cc90202/DCC-esp32/docs/hardware/dcc_loco3_found.png

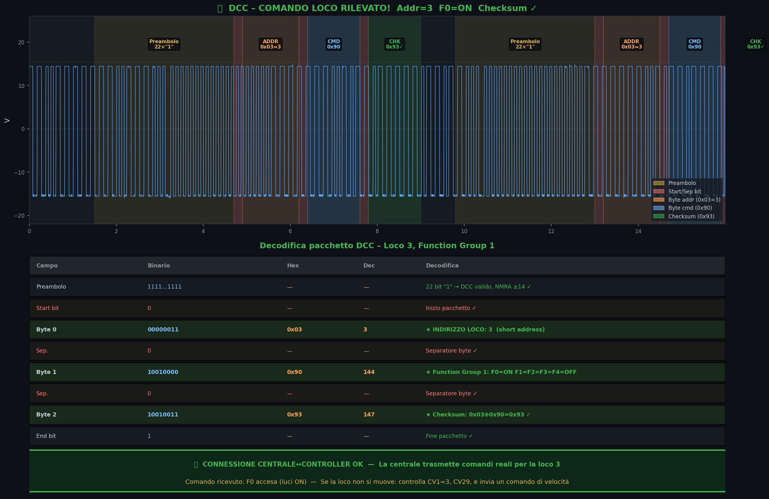
docs/hardware/dcc_loco3_found.png
