cc90202/DCC-esp32/hardware/pcb/fab/board-3d.png

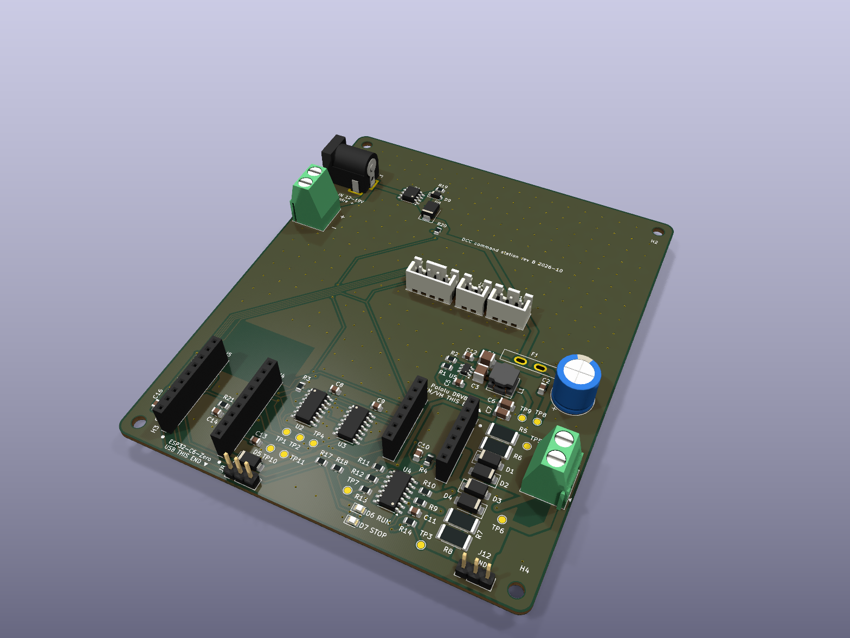
hardware/pcb/fab/board-3d.png
