cc90202/DCC-esp32/docs/specs/wifi-runtime-provisioning.md

# WiFi runtime provisioning

## Goal

Replace build-time WiFi credentials from `.env` with runtime provisioning on
the ESP32-C6.

The command station must:

- use WiFi credentials stored in persistent flash;
- enter setup automatically when no credentials are stored;
- enter setup manually when the blue Resume button on GPIO21 is held for at
  least 10 seconds;
- expose a simple mobile-friendly web page from the ESP32 during setup;
- save the submitted credentials and use them on later boots.

The first implementation should favor predictable embedded behavior over a
fully featured captive portal.

## Current state

WiFi credentials are now loaded from the dedicated `dcc_cfg` flash partition
before station mode starts. The old `.env`/`env!("WIFI_*")` path has been
removed from the runtime and build script.

Provisioning mode now starts a safe SoftAP branch:

- missing credentials select provisioning mode and keep the normal Z21 runtime
  stopped;
- provisioning mode starts WPA2 AP `DCC-Setup-XXXX` on `192.168.4.1`;
- provisioning DHCP assigns `192.168.4.2/24` to the setup client;
- HTTP form handling, credential save, and post-save reboot are implemented;
- OLED feedback shows setup mode, AP SSID, setup URL, and track-disabled state;
- valid stored credentials start station mode;
- runtime GPIO21 provisioning requests first request track stop, then set a
  next-boot flag and reboot into the safe SoftAP branch.

The physical control buttons are already wired and used:

- red Stop button: GPIO22, active-low;
- blue Resume button: GPIO21, active-low;
- both use internal pull-ups and debounce logic in `control_buttons`.

GPIO0/BOOT is not part of this design.

## User flow

### Normal boot

1. Firmware reads stored WiFi credentials from flash.
2. If credentials exist and the blue button override is not active, it starts
   station mode using those credentials.
3. Existing Z21 UDP and runtime services start after WiFi is configured.

If credentials exist but the configured WiFi network is unavailable, the
firmware must keep retrying station mode and must not erase the stored
credentials automatically. The operator can enter setup manually with the
GPIO21 10 second press if the credentials need to be replaced.

### First boot, or missing credentials

1. Firmware finds no valid stored credentials.
2. It enters WiFi setup mode.
3. Track power remains disabled.
4. ESP32 starts an access point named `DCC-Setup-XXXX`.
5. User connects from phone or laptop.
6. User opens `http://192.168.4.1`.
7. The page asks for SSID and password.
8. Firmware validates and saves credentials.
9. Firmware reboots.
10. Next boot starts station mode with the saved credentials.

### Manual setup

The blue Resume button keeps its runtime behavior, with a longer threshold for
provisioning:

```text
GPIO21 blue / Resume
  press < 2s       -> ResumeShortPressed
  press 2s..10s    -> ResumeLongPressed
  press >= 10s     -> WiFi provisioning mode

GPIO22 red / Stop
  press            -> StopPressed
```

The Resume task must not emit `ResumeLongPressed` as soon as 2 seconds elapse.
It should classify the press on release, or on the 10 second timeout, so that a
10 second setup request does not also trigger the 2 second resume action.

Runtime provisioning requests are allowed. When GPIO21 reaches the 10 second
threshold, the firmware should transition to provisioning mode only after
putting the track in a safe disabled state. If this transition is too invasive
for the first implementation, the fallback is to set a persistent
`force_provisioning_on_next_boot` flag and reboot.

## Architecture

Use Clean Architecture principles pragmatically. This is bare-metal firmware,
so the goal is not many abstract layers. The useful boundary is:

- pure policy and validation should not depend on `esp-radio`, HTTP, HTML, or
  flash APIs;
- hardware and protocol details should stay in outer modules;
- the boot composition root wires the concrete pieces together.

## Core types

Introduce a small pure module for WiFi configuration policy, for example:

```text
src/net/wifi_config/
  mod.rs
  credentials.rs
  provisioning_policy.rs
```

Core data:

```rust
pub struct WifiCredentials {
    ssid: heapless::String<32>,
    password: heapless::String<64>,
}

impl WifiCredentials {
    pub fn new(ssid: &str, password: &str) -> Result<Self, CredentialError>;
    pub fn ssid(&self) -> &str;
    pub fn password(&self) -> &str;
}
```

Validation rules:

- SSID must not be empty;
- SSID must be at most 32 bytes;
- password must be empty only if open networks are explicitly supported;
- WPA/WPA2 password must be 8 to 63 bytes;
- password must never be logged.

Initial version should reject open networks unless there is a clear hardware
test need for them.

`password` uses capacity 64 so the type has headroom, but accepted WPA/WPA2
password length is still 8..=63 bytes.

## Provisioning decision

The boot decision should be testable on the host:

```rust
pub enum ProvisioningDecision {
    StationMode,
    ProvisioningMode(ProvisioningReason),
}

pub enum ProvisioningReason {
    MissingCredentials,
    ButtonOverride,
    InvalidStoredCredentials,
}
```

Inputs:

- result of loading stored credentials;
- whether GPIO21 was held for at least 10 seconds;
- whether the stored blob validates.

Rules:

- button override wins;
- missing credentials enter provisioning;
- invalid stored credentials enter provisioning;
- otherwise start station mode.

Connection failures after valid credentials are loaded are not a provisioning
decision. They remain a station-mode reconnect problem until the operator
explicitly requests setup or the stored config is found corrupt.

## Storage port

Define the storage boundary near the policy:

```rust
pub trait WifiCredentialsStore {
    fn load(&mut self) -> Result<Option<WifiCredentials>, StoreError>;
    fn save(&mut self, credentials: &WifiCredentials) -> Result<(), StoreError>;
    fn clear(&mut self) -> Result<(), StoreError>;
}
```

On embedded Rust this can be implemented as a concrete type with equivalent
methods if trait ergonomics or lifetime constraints become awkward. The
important part is the direction of dependency: WiFi policy should not know the
flash driver.

## Persistent format

Use a small versioned record in a dedicated application-owned flash partition.

Selected format:

```text
magic: "DCCWIFI"
version: 1
generation
flags
ssid_len
password_len
ssid bytes
password bytes
checksum
```

Requirements:

- distinguish missing config from corrupt config;
- reject partial/corrupt writes;
- allow overwriting credentials;
- allow clearing credentials later;
- avoid logging secret contents.

### Storage spike decision

Decision for the first runtime provisioning release: use a dedicated versioned
blob in a small application-owned flash partition, not NVS.

Rationale:

- the current stack is `esp-hal`/`esp-rtos`/`esp-radio`, not ESP-IDF;
- `esp-radio` on ESP32-C6 currently needs local NVS symbol stubs in
  `src/net/mod.rs`, so treating NVS as an application persistence dependency
  would couple this feature to a storage path that is not actually initialized;
- the project already has `partitions.csv`, so a dedicated data partition is
  explicit and reviewable;
- blob encode/decode, checksum validation, corruption handling, and flag
  semantics can be host-tested without flash hardware;
- the concrete flash driver remains an outer detail and can be replaced later
  without changing WiFi provisioning policy.

The partition added for this feature, as it appears in `partitions.csv`:

```text
# Name,     Type, SubType, Offset,  Size,    Flags
dcc_cfg,    data, nvs,     0x1E0000, 0x3000,
```

To keep the 2 MiB flash layout valid, the factory app partition was shrunk from
`0x1F0000` to `0x1D0000` so that `dcc_cfg` fits at `0x1E0000`. Application
credentials are deliberately kept out of the pre-existing `nvs` partition, which
stays available for platform and radio use: `dcc_cfg` shares its subtype but is
a separate partition with its own offset, owned by the application.

Flash layout inside `dcc_cfg`:

- three 4 KiB erase sectors, with the first two used by the store;
- one fixed-size credential record per sector: slot A and slot B;
- each record contains a monotonically increasing generation counter;
- load chooses the newest valid record using wrapping generation comparison;
- save erases and writes only the inactive sector, then subsequent loads prefer
  the newer valid slot after checksum validation;
- clear erases both slots;
- missing means both slots are erased (`0xff`);
- corrupt means at least one slot contains non-empty bytes but no slot validates.

The third sector is reserved to keep the implementation on
`esp_bootloader_esp_idf::partitions::FlashRegion`: version `0.4.0` rejects an
erase whose `to` bound is exactly the partition end, while slot B erase ends at
`0x2000`.

Record shape:

```text
magic: "DCCWIFI"
version: 1
generation: u32
flags: u8
ssid_len: u8
password_len: u8
ssid bytes [32]
password bytes [64]
padding to 4-byte boundary
checksum: u32
```

Flags:

- bit 0: `force_provisioning_on_next_boot`;
- all other bits must be zero in version 1.

Checksum:

- use a small deterministic checksum implemented in the host-testable codec;
- checksum covers every record byte except the checksum field itself;
- checksum mismatch maps to corrupt config, never to missing config.

Reset strategy:

- after credentials are saved successfully from the setup flow, call
  `esp_hal::system::software_reset()`;
- the same API is already used by panic/fail-fast paths in `src/bin/main.rs`,
  so no new reset dependency is introduced;
- do not reset until the store reports a successful save.

Power-loss behavior:

- power loss during inactive-sector erase/write leaves the previous valid
  sector active;
- power loss after the inactive slot validates makes the newer generation
  active;
- if both slots are corrupt, boot enters provisioning due to
  `InvalidStoredCredentials`;
- this behavior needs HIL validation before relying on field updates.

Typed error surface:

```rust
pub enum StoreError {
    FlashRead,
    FlashErase,
    FlashWrite,
    Corrupt,
    MissingCredentials,
    BufferTooSmall,
}
```

The codec should distinguish `Missing` from `Corrupt`; the flash adapter should
map driver errors to read/erase/write variants without logging credentials.

## WiFi module changes

`src/net/wifi.rs` no longer uses compile-time credentials:

```rust
env!("WIFI_SSID")
env!("WIFI_PASS")
```

to runtime input:

```rust
pub(super) fn client_mode_config(credentials: &WifiCredentials) -> ModeConfig
```

The network task receives credentials from boot wiring rather than reading them
from environment variables.

## Provisioning mode

Provisioning mode should be exclusive in the first implementation.

When active:

- do not start normal Z21 networking;
- keep track power disabled;
- do not initialize DCC/RMT, RailCom, scheduler, or track-output tasks;
- start WiFi AP mode;
- start HTTP server;
- save credentials;
- reboot after successful save in Task 12.

This is safer and simpler than trying to run setup mode while the DCC runtime
is active. Provisioning is a safe setup branch: while credentials are being
configured, every train on the circuit must remain stopped because no DCC
waveform or track enable path is started.

Operator feedback:

- OLED, when available, should show setup mode, AP SSID,
  `http://192.168.4.1`, and track-disabled state;
- serial logs may show AP SSID and setup URL;
- serial logs must never show passwords, including the submitted station
  password and the fixed provisioning AP password;
- status LEDs may keep the existing WiFi-connecting indication unless a
  dedicated setup pattern is added later.

## Access point

Initial AP:

```text
SSID: DCC-Setup-XXXX
URL:  http://192.168.4.1
```

`XXXX` is derived from a stable chip identifier or MAC suffix.

AP password:

- first version uses WPA2 with fixed password `dcc-setup`;
- do not use an open AP;
- document the password in README; do not print it on the serial log.

### Access point spike decision

Use the SoftAP support already exposed by `esp-radio`; do not introduce a
custom WiFi/AP abstraction or raw radio setup.

Relevant upstream APIs in `esp-radio 0.17.0`:

```rust
esp_radio::wifi::ModeConfig::AccessPoint(AccessPointConfig)
```

`WifiController::set_config` maps `ModeConfig::AccessPoint` to the native
`WIFI_MODE_AP` mode and applies the AP configuration through `apply_ap_config`.
`esp_radio::wifi::Interfaces` already exposes both station and AP network
devices:

```rust
pub struct Interfaces<'d> {
    pub sta: WifiDevice<'d>,
    pub ap: WifiDevice<'d>,
}
```

Production provisioning mode should therefore use `interfaces.ap` with a
separate `embassy-net` stack runner. The station path should keep using
`interfaces.sta`.

Minimal configuration shape:

```rust
let ap_config = ModeConfig::AccessPoint(
    AccessPointConfig::default()
        .with_ssid("DCC-Setup-XXXX".into())
        .with_password("dcc-setup".into())
        .with_auth_method(AuthMethod::Wpa2Personal)
        .with_max_connections(1),
);
wifi_controller.set_config(&ap_config)?;
wifi_controller.start_async().await?;
```

Keep `max_connections` low for setup mode so the AP admits only the expected
single-phone provisioning flow.

AP IP address:

- bind the ESP32 AP interface to `192.168.4.1/24`;
- use `embassy_net::Config::ipv4_static`;
- no gateway is needed for the ESP32 setup page;
- DNS servers can remain empty for the first release.

Expected stack configuration:

```rust
let config = embassy_net::Config::ipv4_static(StaticConfigV4 {
    address: Ipv4Cidr::new(Ipv4Address::new(192, 168, 4, 1), 24),
    gateway: None,
    dns_servers: heapless::Vec::new(),
});
```

DHCP decision:

- phone clients need automatic IP assignment for acceptable UX;
- `embassy-net`'s current `dhcpv4` feature is a DHCP client socket, not a DHCP
  server;
- `esp-radio` AP mode does not provide a DHCP server through `embassy-net`;
- provisioning mode therefore runs a small DHCP server task over
  `embassy_net::udp::UdpSocket`;
- packet parsing and emission use existing `smoltcp::wire` DHCPv4 primitives;
- the direct `smoltcp` dependency is intentionally feature-limited to
  `proto-dhcpv4`, `medium-ethernet`, and `socket-dhcpv4`: `proto-dhcpv4`
  exposes the DHCP wire types, `medium-ethernet` is required by those wire
  types for Ethernet hardware addresses, and `socket-dhcpv4` satisfies
  `smoltcp` 0.12's socket feature guard when `medium-ethernet` is enabled;
- the first release intentionally leases only `192.168.4.2/24` and does not add
  DNS or captive portal behavior.

HTTP dependency decision:

- the current `embassy-net` feature set is `dhcpv4`, `medium-ethernet`, `tcp`,
  and `udp`;
- AP-only provisioning does not need Z21 UDP sockets, station reconnect logic,
  or normal network status events.

Composition and lifetime decision:

- `boot.rs` remains the composition root;
- station mode and provisioning mode are mutually exclusive boot branches;
- the provisioning branch owns `peripherals.WIFI`, starts AP + HTTP, and never
  starts Z21 or DCC runtime tasks;
- radio initialization should be factored so station and provisioning paths do
  not duplicate `esp_radio::init` statics;
- track output must stay disabled before and during AP/HTTP provisioning.

HIL checks required before production HTTP work:

- ESP32-C6 advertises `DCC-Setup-XXXX` with WPA2;
- a phone can associate with the AP;
- ESP32 binds `192.168.4.1/24` on `interfaces.ap`;
- DHCP strategy assigns a phone address without manual static configuration;
- added TCP/HTTP buffers fit RAM with display and control tasks disabled in
  provisioning mode.

## HTTP interface

### HTTP implementation spike decision

Use a minimal hand-written HTTP/1.1 handler on top of
`embassy_net::tcp::TcpSocket`; do not add a web framework or generic HTTP
server crate for the first provisioning release.

Rationale:

- the setup server has exactly two routes: `GET /` and `POST /save`;
- the device serves a local, temporary, physically gated setup AP;
- HTTPS, keep-alive, chunked transfer, compression, and file serving are out of
  scope;
- a small parser can be host-tested without WiFi hardware;
- avoiding another HTTP dependency keeps binary size, feature interactions, and
  no_std compatibility risks low.

Required dependency change for the production HTTP task:

```toml
embassy-net = { version = "0.8.0", features = ["dhcpv4", "medium-ethernet", "tcp", "udp"] }
```

`embassy-net 0.8.0` does not expose a `TcpListener`; each server socket is a
`TcpSocket` put into listening mode with `accept(80)`. The first production
version should run one HTTP socket at a time:

```rust
let mut socket = TcpSocket::new(stack, rx_buffer, tx_buffer);
socket.set_timeout(Some(Duration::from_secs(10)));
socket.accept(80).await?;
handle_one_request(&mut socket, store).await;
socket.close();
socket.flush().await?;
```

This matches the setup use case and avoids concurrency/resource bloat. If a
phone opens parallel connections, extra connections may wait or fail; the user
can retry. That is acceptable for the first setup flow.

Use `abort()` only for hard failure paths where no well-formed response can be
sent, such as oversized headers before request classification, timeout while
reading the request, or socket-level connection reset.

Parser boundary:

- keep HTTP parsing in a pure host-testable module;
- embedded socket code only reads bytes, enforces limits, writes responses, and
  calls the parser;
- no `async-trait`, trait objects, or generic parser abstraction are needed;
- use fixed buffers and borrowed slices where possible.

Request limits:

```text
max complete request bytes: 1024
max header section bytes:   768  (includes request line and CRLF CRLF)
max body bytes:             256
max request line bytes:     128  (included in header section)
max single header line:     128
max header count:            16
```

Accounting:

- request bytes are the exact bytes read before response generation;
- header section bytes include request line, all header lines, and the terminal
  `\r\n\r\n`;
- for `POST /save`, `header section bytes + Content-Length` must be <= 1024;
- body bytes must equal `Content-Length` and be <= 256;
- `GET /` must not require a body; any received body bytes are ignored after
  the response because the connection is closed.

Supported requests:

```text
GET / HTTP/1.0
GET / HTTP/1.1
POST /save HTTP/1.0
POST /save HTTP/1.1
```

Malformed or unsupported requests:

- unsupported method: `405 Method Not Allowed`;
- unsupported path: `404 Not Found`;
- unsupported HTTP version: `505 HTTP Version Not Supported`;
- request line longer than 128 bytes: `414 URI Too Long`;
- header section larger than 768 bytes: `431 Request Header Fields Too Large`;
- single header line longer than 128 bytes: `431 Request Header Fields Too Large`;
- more than 16 headers: `431 Request Header Fields Too Large`;
- missing `Content-Length` on `POST /save`: `411 Length Required`;
- duplicate `Content-Length`: `400 Bad Request`;
- invalid `Content-Length`: `400 Bad Request`;
- `Content-Length` plus header section larger than 1024 bytes:
  `413 Payload Too Large`;
- early EOF before declared body length: close connection without saving and
  without claiming success;
- body larger than 256 bytes: `413 Payload Too Large`;
- unsupported content type on `POST /save`: `415 Unsupported Media Type`;
- malformed form or invalid percent encoding: `400 Bad Request`;
- valid form with invalid WiFi credentials: `200 OK` with validation error
  page, because the browser should stay on the setup form.

Timeout behavior:

- set a 10 second socket timeout for accept/read/write work;
- if no complete request arrives before timeout, close or abort the socket
  without saving credentials;
- if the request is already classified and a response can still be sent, return
  `408 Request Timeout` with `Connection: close`;
- timeout must not block the single HTTP socket indefinitely.

Response behavior:

- always send `Connection: close`;
- include `Content-Length`;
- no chunked transfer;
- no keep-alive;
- no redirects in the first release;
- never log the submitted station password.

Form parsing:

- content type: `application/x-www-form-urlencoded`;
- accepted fields: `ssid`, `password`;
- unknown fields ignored;
- duplicate `ssid` or `password` rejected;
- `+` decodes to space;
- `%XX` percent escapes decode only valid bytes;
- invalid percent escapes are rejected;
- decoded SSID/password must be valid UTF-8;
- decoded credentials are validated through `WifiCredentials::new`.

Buffer decision:

- TCP RX buffer: 1024 bytes;
- TCP TX buffer: 1536 bytes for one full response page;
- if the final HTML exceeds the TX buffer, split writes explicitly rather than
  increasing buffers blindly;
- keep `StackResources` sized for AP + HTTP + DHCP sockets.

Open item for Task 11:

- implement and host-test the parser before wiring it to `TcpSocket`;
- then add the `tcp` feature and compile the embedded server path;
- HIL must prove a phone can load `http://192.168.4.1` and submit the form.

Initial routes:

```text
GET  /      -> setup page
POST /save  -> validate and save credentials
```

Optional later route:

```text
GET /status -> JSON status for a richer UI
```

The HTML should be embedded in firmware. It must not depend on CDN assets or
Internet access because the phone is connected to the ESP32 setup AP.

`POST /save` uses `application/x-www-form-urlencoded`.

Request limits:

- reject unsupported content types;
- reject oversized request bodies before parsing;
- first implementation max body length: 256 bytes;
- accepted fields: `ssid`, `password`;
- ignore unknown fields;
- reject duplicate `ssid` or `password` fields.

UI guidelines:

- mobile-first layout;
- clear title: `Configura WiFi DCC`;
- SSID input;
- password input with show/hide toggle;
- primary action: `Salva e riavvia`;
- visible error messages for invalid SSID/password;
- confirmation page after successful save.

Keep it visually polished but simple. No frontend framework.

## Captive portal

Do not include captive portal in the first implementation.

First release:

- user connects to `DCC-Setup-XXXX`;
- user opens `http://192.168.4.1`.

Future release:

- DNS server replies with `192.168.4.1` for all names;
- common Android/iOS captive portal probes redirect to setup page.

Captive portal is useful but adds DNS behavior and mobile OS edge cases. It is
not required to validate the main provisioning path.

## Boot integration

High-level boot flow:

```text
boot
  init minimal runtime
  if GPIO21 is already pressed, wait up to 10s for provisioning override
  load WiFi credentials
  decide StationMode vs ProvisioningMode

  if ProvisioningMode:
      keep track output disabled
      start AP + HTTP setup
      save credentials
      reboot

  if StationMode:
      start normal WiFi station mode
      start Z21 and runtime tasks
```

The exact placement in `boot.rs` should minimize churn. The boot module can
remain the composition root.

Boot must not add a 10 second delay when GPIO21 is not pressed. It should only
wait for the 10 second override window if GPIO21 is already active-low at the
time the provisioning decision is made.

Task 12 final behavior: after successful credential save, call
`esp_hal::system::software_reset()` to reboot after the success response is
sent and flushed successfully. Do not show reboot success or reset until the
store reports that credentials were written successfully.

## Button integration

`control_buttons` should classify GPIO21 press duration into a richer enum:

```rust
pub enum ResumePress {
    Short,
    Long,
    Provisioning,
}
```

Mapping:

```text
Short        < 2s
Long         2s..10s
Provisioning >= 10s
```

Runtime delivery options:

1. Add a provisioning request sender to `resume_button_task`.
2. Emit a generic control event and let a coordinator dispatch to fault manager
   or provisioning.

Recommended first implementation: add a separate provisioning channel. Do not
put provisioning into `FaultEvent`; it is not a fault-manager responsibility.

If provisioning is requested while normal runtime is active, the receiver of
that channel must first disable track output and pause DCC scheduling before
starting setup mode or rebooting into setup mode.

## Tests

Host tests:

- credential validation accepts valid WPA2 credentials;
- credential validation rejects empty SSID;
- credential validation rejects too long SSID;
- credential validation rejects invalid password lengths;
- provisioning decision chooses setup for missing credentials;
- provisioning decision chooses setup for button override;
- provisioning decision chooses station mode for valid credentials;
- button duration maps `<2s`, `2s..10s`, `>=10s` correctly.

Embedded/manual tests:

- flash without credentials enters AP setup;
- phone connects to `DCC-Setup-XXXX`;
- `http://192.168.4.1` serves the setup page;
- invalid form shows an error and does not save;
- valid form saves credentials and triggers automatic reboot;
- next boot connects to configured WiFi;
- valid stored credentials with WiFi unavailable retry station mode and do not
  erase credentials;
- holding GPIO21 for at least 10 seconds re-enters setup;
- boot without GPIO21 pressed does not wait 10 seconds;
- red Stop/GPIO22 behavior is unchanged;
- blue short and long Resume behavior is unchanged below 10 seconds.

## Hardware acceptance checklist

Software validation can cover parsing, storage, policy, reboot decisions, and
target builds. The following checks require ESP32-C6 hardware, OLED when
installed, and a phone or computer connected to the provisioning AP:

- flash firmware with erased or missing WiFi credentials;
- verify setup mode starts automatically;
- verify DCC, RailCom, Z21 UDP, and track output are not started in setup mode;
- verify AP SSID format `DCC-Setup-XXXX`;
- connect to the AP with password `dcc-setup`;
- verify DHCP assigns the client an address on `192.168.4.0/24`;
- open `http://192.168.4.1`;
- submit invalid SSID/password and verify an error page with no save;
- submit valid credentials and verify the success page;
- verify ESP32 reboots after the success response;
- verify next boot connects to the configured WiFi;
- power-cycle and verify credentials persist;
- make configured WiFi unavailable and verify station reconnect retry without
  erasing credentials;
- hold GPIO21 for at least 10 seconds and verify safe setup mode on next boot;
- verify GPIO21 short press still performs Resume;
- verify GPIO21 press >= 2 seconds and < 10 seconds still performs long Resume
  behavior and does not enter setup;
- verify GPIO22 Stop/E-stop behavior is unchanged;
- verify OLED shows setup mode, AP SSID, `http://192.168.4.1`, and
  track-disabled state when display is installed;
- capture serial logs and verify they show AP SSID and setup URL but never the
  fixed AP password or submitted station password.

Current validation status in this task: `cargo test-host`, `cargo check-esp`,
`cargo build-esp-release`, `cargo fmt --check`, host `cargo clippy`, and
`git diff --check` passed. Hardware-in-the-loop acceptance testing remains required before
treating the feature as physically validated on the command-station board.

## Security and safety

Safety:

- provisioning mode must keep track power disabled;
- setup should not emit DCC packets;
- failed WiFi connection should not energize the track by itself.

Security:

- never log WiFi password;
- do not expose provisioning page in normal station mode;
- do not run AP indefinitely when station mode is working;
- use physical button or missing credentials as the setup gate.

First implementation does not need HTTPS. The setup AP is local, temporary,
and physically gated. This is acceptable for the project scope.

## Implementation phases

### Phase 1: policy and button classification

- Add `WifiCredentials`.
- Add validation.
- Add provisioning decision logic.
- Add GPIO21 duration classification tests.

### Phase 2: runtime credentials input

- Change `wifi::client_mode_config` to accept `WifiCredentials`.
- Remove direct `env!` usage from normal WiFi path.
- Do not retain `.env` as a runtime credential path.

### Phase 3: persistent store

- Implement `dcc_cfg` flash blob storage.
- Add encode/decode tests for stored record format.
- Treat corrupt config as `InvalidStoredCredentials`.
- Keep the previously valid slot active if save is interrupted during inactive
  sector erase/write.
- Prefer the newer generation only after the inactive slot validates.

### Phase 4: provisioning access point and HTTP

- Start AP mode.
- Serve embedded HTML.
- Validate form submission.
- Save credentials.
- Reboot.

### Phase 5: documentation and acceptance testing

- Update README setup instructions.
- Update hardware docs for GPIO21 10 second setup action.
- Run host tests and `cargo check-esp`.
- Perform hardware provisioning test from phone.

## Non-goals for the first version

- captive portal DNS;
- WiFi network scanning;
- admin password management;
- OTA firmware upload;
- editing credentials while normal Z21 runtime is active;
- HTTPS.

These can be added after the basic setup path is stable on hardware.
