cc90202/DCC-esp32/hardware/pcb/fab/board-bottom.png

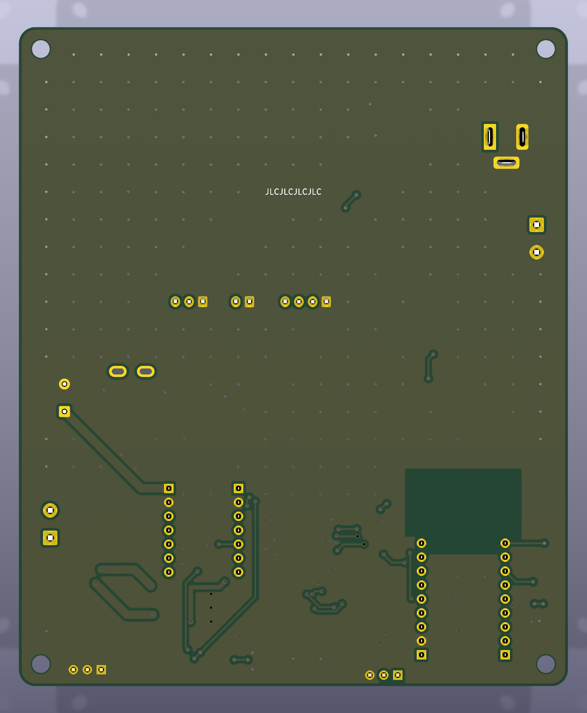
hardware/pcb/fab/board-bottom.png
