cc90202/DCC-esp32/hardware/pcb/fab/board-top.png

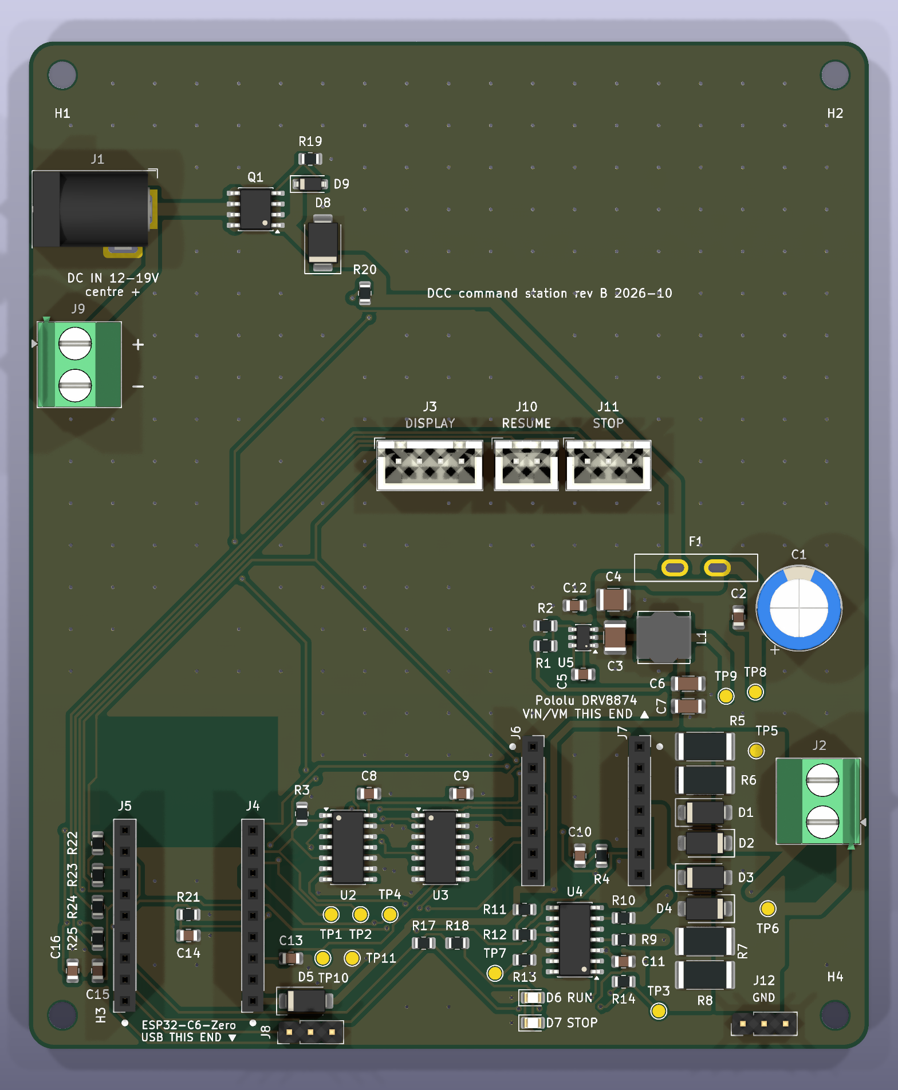
hardware/pcb/fab/board-top.png
