cc90202/DCC-esp32/hardware/pcb/fab/dcc-station-bom.csv

Comment | Designator | Footprint | LCSC Part #
470uF 35V | C1 | CP_Radial_D10.0mm_P5.00mm | C2835692
100nF 50V X7R | C2,C5,C8,C9,C10,C11,C12,C13,C14,C15,C16 | C_0805_2012Metric | C49678
10uF 50V X7R | C3,C4 | C_1210_3225Metric | C138687
22uF 25V | C6,C7 | C_1206_3216Metric | C12891
SS34 | D1,D2,D3,D4 | D_SMA | C8678
SS14 | D5 | D_SMA | C2480
LED green 0805 | D6 | LED_0805_2012Metric | C2297
LED red 0805 | D7 | LED_0805_2012Metric | C84256
SMBJ24A | D8 | D_SMB | C135060
BZT52C12 | D9 | D_SOD-123 | C727004
MF-R400 4A 30V | F1 | Polyfuse_Radial_P5.08mm_W14.5mm | C208488
DC-005-5A-2.5 | J1 | BarrelJack_XKB_DC-005-5A | C381115
TRACK | J2,J9 | TerminalBlock_Phoenix_MKDS-1,5-2_1x02_P5.00mm_Horizontal | C474950
DISPLAY | J3 | JST_XH_B4B-XH-A_1x04_P2.50mm_Vertical | C144395
ESP32-C6-Zero left row | J4,J5 | PinSocket_1x09_P2.54mm_Vertical | C22438159
Pololu DRV8874 #4035 left row | J6,J7 | PinSocket_1x07_P2.54mm_Vertical | C54876729
SERIAL TX RX GND | J8,J12 | PinHeader_1x03_P2.54mm_Vertical | C2937625
RESUME | J10 | JST_XH_B2B-XH-A_1x02_P2.50mm_Vertical | C158012
STOP | J11 | JST_XH_B3B-XH-A_1x03_P2.50mm_Vertical | C144394
10uH 3A | L1 | L_Bourns_SRN6045TA | C2046332
AO4407A | Q1 | SOIC-8_3.9x4.9mm_P1.27mm | C2841482
100k 1% | R1,R20,R3,R19 | R_0805_2012Metric | C96346
13.7k 1% | R2 | R_0805_2012Metric | C17448
10k | R4,R21,R22,R23 | R_0805_2012Metric | C17414
4.7R 1W | R5,R6,R7,R8 | R_2512_6332Metric | C25489
1k | R9,R10,R14,R24,R25 | R_0805_2012Metric | C17513
22k | R11 | R_0805_2012Metric | C17560
4.7k | R12 | R_0805_2012Metric | C17673
100R | R13 | R_0805_2012Metric | C17408
470R | R17,R18 | R_0805_2012Metric | C17710
74HC08 | U2 | SOIC-14_3.9x8.7mm_P1.27mm | C337768
74HC14 | U3 | SOIC-14_3.9x8.7mm_P1.27mm | C6820
LM339 | U4 | SOIC-14_3.9x8.7mm_P1.27mm | C7948
TPS54302 | U5 | TSOT-23-6 | C311983
