cc90202/DCC-esp32/hardware/pcb/fab/dcc-station.step

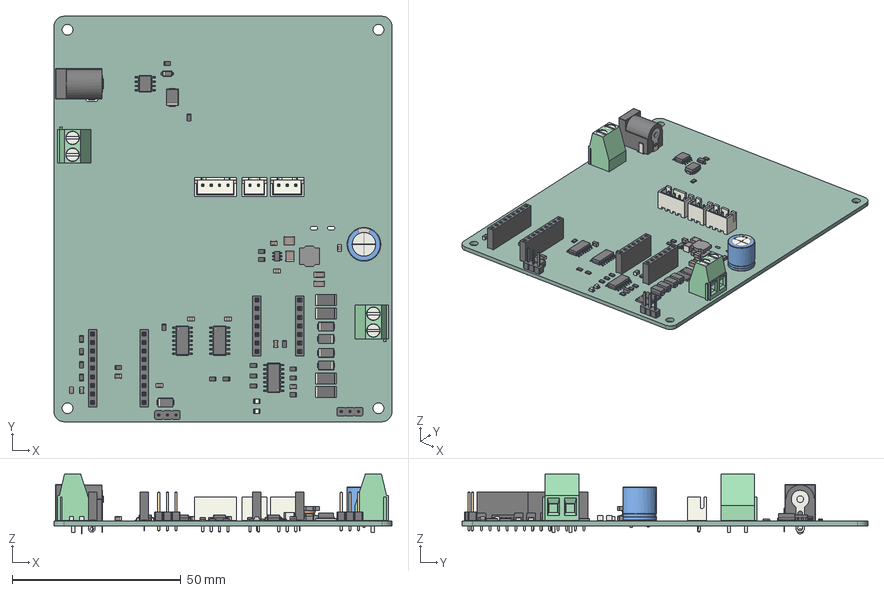
[picture p5: CAD file, 2026-11-02]
hardware/pcb/fab/dcc-station.step
100.0 x 120.0 x 17.7 mm
R_0805_2012Metric x 19
L_Bourns_SRN6045TA
C_0805_2012Metric x 11
D_SMB
SOIC-14_3.9x8.7mm_P1.27mm x 3
PinSocket_1x09_P2.54mm_Vertical x 2
TSOT-23-6
D_SMA x 5
C_1206_3216Metric x 2
LED_0805_2012Metric x 2
C_1210_3225Metric x 2
D_SOD-123
TerminalBlock_Phoenix_MKDS-1,5-2_1x02_P5.00mm_Horizontal x 2
BarrelJack_Horizontal
PinHeader_1x03_P254mm_Vertical x 2
R_2512_6332Metric x 4
JST_B2B_XH_A
SOIC-8_3.9x4.9mm_P1.27mm
CP_Radial_D100mm_P500mm
PinSocket_1x07_P2.54mm_Vertical x 2
JST_B4B_XH_A
JST_B3B_XH_A
dcc-station_PCB
