cc90202/DCC-esp32/docs/hardware/wiring.md

# Breadboard wiring

The single description of the bench circuit: what is connected to what and why
the values are what they are. State on
13 September 2026. It must be updated with every change on the breadboard.

The parts list is in `components-inventory.md`. How the firmware behaves
around the cutout is in `docs/specs/rmt-isr-dcc-railcom-flow.md`.

## What the circuit does

The ESP32-C6 board generates the DCC waveform and feeds it to the DRV8874
H-bridge, which drives the two rails. After every packet addressed to a
locomotive the board opens a RailCom cutout: for about 425 microseconds the
bridge brakes, that is it shorts the two rails together, and the decoder in
the locomotive answers with small current pulses. A resistor in series with
each rail turns those pulses into millivolts, an LM339 comparator turns them
into logic levels and the board's serial port reads them on GPIO5.

## Which standard applies

The RailCom part of this circuit is governed by RCN-217, the RailCommunity
RailCom specification: the detector, the cutout and their timings are defined
there. The NMRA standards cover the DCC waveform itself and, in S-9.3.2, the
decoder's side of the transmission. Links and editions are in
`docs/specs/dcc-railcom-references.md`.

This circuit has not been through a conformance measurement campaign. What is
written here is what was built and what was measured.

The read front end was designed by comparing RCN-217 (edition of 24 November
2025) with three working designs: the example circuit in the standard itself,
the ESP32 detector by Christophe Bobille published by Locoduino, and the
MTB-RC detector by kmzbrnoI. All three use the same comparator we use.

## Power supply

A single star ground, where every return goes: the board, the bridge, the
logic chips and the comparator.

Three supply lines. The 15 V from the bench supply enters only the VIN pin of
the Pololu module. The 5 V is taken from the 5 V output pin of the ESP32-C6
board and feeds the LM339 alone, because that is the operating point the
manufacturer characterises the comparator at. The board's 3.3 V output pin
feeds the 74HC08 and the 74HC14, and is also the pull-up of the comparator
output.

The two logic chips are on 3.3 V and not on 5 V for a reason worth keeping in
mind on the printed board too. Their inputs come from GPIO2 and GPIO4, which
the board drives at 3.3 V, and a chip of the HC family asks for seventy per
cent of its own supply before it reads a level as high: on 5 V that would be
3.5 V, above what the board gives, while on 3.3 V the threshold is about 2.3 V
and there is margin to spare. The measurement agrees: during the cutout the
bridge inputs, which come from the outputs of the 74HC14, sit at about 3.2 V,
that is at the chip's own supply.

The VM pin of the module must not be connected: it is a measurement point
after the protection, not an input.

On the bench both lines come from the output pins of the ESP32-C6 board, and
both are therefore present only while the board is powered. Only on a future
printed board will the comparator's 5 V have to come from a converter fed by
the 15 V.

## The board and its pins

GPIO2 carries the DCC waveform generated by the RMT peripheral. GPIO4 is the
run/cutout signal: high during normal transmission, low during the RailCom
cutout. GPIO18 wakes the bridge and is held low until the firmware is ready.
GPIO5 is the serial input that receives the decoder's answer, with the
internal pull-up enabled. GPIO3 is the short-circuit detector input and comes
from the FAULT pin of the bridge. GPIO19 and GPIO20 are the display data and
clock. GPIO21 and GPIO22 read the resume and stop buttons. GPIO14 and GPIO15
drive the green and red LEDs.

## The bridge and the brake logic

The DRV8874 works in PWM mode: its PMODE pin is at 3.3 V. In this mode the two
inputs IN1 and IN2 drive the two outputs directly, and with both inputs high
the bridge brakes. GPIO18 reaches the sleep pin of the module, the one the
firmware calls SLEEP and holds low until it is ready; the exact wording of the
silkscreen next to that pin on the Pololu carrier has to be read on the board
itself. The two outputs OUT1 and OUT2 go to the two rails, each through its own
sense resistor, and the module's ground goes to the star ground.

The two inputs do not come from the board directly; they pass through two AND
gates of the 74HC08 and two inverters of the 74HC14. The first AND gate
receives the DCC waveform from GPIO2 and the run signal from GPIO4; the second
receives the DCC waveform inverted by one 74HC14 inverter and the same run
signal. The gate outputs, pins 3 and 6 of the 74HC08, enter two 74HC14
inverters, pins 5 and 9, and their outputs, pins 6 and 8, go to the bridge
inputs crosswise: IN1 from pin 8, IN2 from pin 6.

The pin numbers on the input side of the two logic chips are not recorded in
any earlier document and have not been checked component by component on the
breadboard; what follows is what the standard pinouts of the two parts allow,
given the output pins above, and it is the one thing in this section still to
be confirmed by eye. On the 74HC08 the gate whose output is pin 3 has its
inputs on pins 1 and 2, and the gate whose output is pin 6 has its inputs on
pins 4 and 5: GPIO2 and GPIO4 therefore land on pins 1 and 2 in some order, and
the inverted waveform and GPIO4 on pins 4 and 5 in some order. Which of the two
pins of each pair carries which signal makes no difference electrically,
because an AND gate treats its inputs alike. The 74HC14 inverter that produces
the inverted waveform for the second gate is not the one on pins 5 and 6 nor
the one on pins 9 and 8, since those two are already used after the gates: it
is one of the four remaining, whose inputs are pins 1, 3, 11 and 13 and whose
outputs are, in the same order, pins 2, 4, 10 and 12.

Both logic chips take their 3.3 V on pin 14 and their ground on pin 7, and it
is across those two pins that the 100 nF of each sits. The inputs of the unused
gates and inverters are not described in the earlier documents either, and what
they are tied to, if anything, has to be checked on the breadboard.

As a result, outside the cutout the bridge reproduces the DCC waveform as
before, and inside the cutout, with GPIO4 low, both inputs rise and the bridge
brakes. Measured on 1 September: during the cutout both inputs sit at about
3.2 V and the rails are at zero.

The firmware does not command a duration but two instants, both counted from
the reference edge, that is from the polarity inversion that closes the packet:
the brake comes in at 28 microseconds and is released at 454. The brake itself
therefore lasts about 425 microseconds. The capture of 2 September measures a
33 microsecond stub before the brake and 424 microseconds of rails at zero,
which puts the end at 457 from the edge against the 454 commanded: the bridge
is some three microseconds late in letting go.

On the run signal, between GPIO4 and the 74HC08, a resistor to ground holds the
pin low while the board is not yet driving it; the design value is 100 kΩ. A
low run signal means brake, so what this resistor gives at power-up is a
defined state, not an idle one: the bridge is harmless in that moment because
GPIO18 is low and the bridge is asleep, not because of this resistor.

## The short-circuit detector

The FAULT pin of the bridge goes to GPIO3, so the firmware's detector watches
the bridge. On that pin there is a capacitor to ground, confirmed by eye on the
bench; the value is 100 nF as far as the notes go, and whether a resistor is
fitted with it, and where, has not been settled. The pin is open drain and
active low, so it can only pull down; the line is held up by the pull-up inside
the ESP32-C6, which the firmware enables on GPIO3, and that pull-up is weak,
around 45 kΩ, so the capacitor slows the line down appreciably when FAULT lets
go. This matters for the open bug below.

## The sense resistors

Between the bridge output and each of the two rails sits a sense resistor: two
4.7 Ω resistors in parallel, about 2.35 Ω. Across each one, two 1N5819 diodes
in anti-parallel let the traction current through and leave the much smaller
decoder current alone. Both rails are equipped the same way.

The decoder current produces tens of millivolts across each resistor; its
direction depends on how the locomotive sits on the track, which is why the
comparator watches both rails. Outside the cutout the two nodes swing with the
DCC waveform and the diodes keep them within half a volt.

One resistor per rail is our own variation. The standard and the other designs
use a single resistor and build a negative supply to see the opposite
direction too; having only positive voltages, we put one resistor per rail.
During braking one node goes above zero and the other below, and watching the
one above is enough.

The diodes are in all three reference designs. At the 130 millivolts measured
with only the decoder signal present they conduct a few microamperes and steal
nothing; above half a volt, that is when traction current flows, they divert it
through themselves.

## The comparator

The LM339 is powered at 5 V on pin 3, with ground on pin 12 and a 100 nF
capacitor between the two.

The threshold is a voltage of about 18.5 mV obtained from a divider between the
5 V and ground, 22 kΩ plus 4.7 kΩ on top and 100 Ω at the bottom, brought to
pins 5 and 7. It corresponds to 8 mA through the sense resistor. The standard
requires the detector to read a current above ten milliamperes as a zero and
below six as a one: the threshold must fall in that band, and eight is the
value recommended by OpenDCC.

The rail-side node of the first sense resistor reaches pin 4 and that of the
second reaches pin 6, each through a 1 kΩ resistor that protects the chip while
those nodes swing by tens of volts outside the cutout.

Pins 4 and 6 are the inverting inputs of the first two comparators of the
LM339, and pins 5 and 7, which carry the threshold, are the non-inverting ones.
The output therefore goes low when the signal rises above the threshold, that
is when current is flowing, and is high when there is none. This is the reason
for what the measurements show on GPIO5: the line rests high during the cutout
and the decoder's pulses appear as short trips to ground.

The two outputs, pins 1 and 2, are tied together: they are open collector and
can only pull low. From the common node a 1 kΩ resistor goes up to the 3.3 V,
not to the 5 V, so GPIO5 never sees more than 3.3 V. The same node goes to
GPIO5.

The manufacturer characterises the LM339 at 5 V, so that is the operating point
with guaranteed numbers. Because its outputs can only pull down, the pull-up to
3.3 V means the board pin cannot see more than 3.3 V under any condition, not
even a fault.

## Display, buttons and LEDs

The earlier breadboard documents that described this part have been lost, so
what follows is what the firmware requires. It is right about the electrical
arrangement, because the firmware would not work otherwise, but it has not
been checked against the breadboard component by component.

**Display.** The SSD1306 module sits on the board's I2C bus at 400 kHz, data on
GPIO19 and clock on GPIO20, plus its supply and ground. The bus pull-ups are
the ones on the module; none are fitted on the breadboard, and the inventory
lists none.

**Buttons.** Both inputs are configured with the pull-up inside the ESP32-C6
and the firmware reads a press as a low level. Each button therefore has one
side on its pin, GPIO21 for resume and GPIO22 for stop, and the other side on
the star ground. No external resistor is needed and none is in the inventory.

**LEDs.** Both are plain outputs driven high to light, green on GPIO14 and red
on GPIO15, so each LED has its anode towards the pin and its cathode towards
ground. The inventory lists no series resistors for them; whether one is fitted
on each, and of what value, is the one thing in this section that has to be
checked by eye on the breadboard.

## The capacitors

Five, all 100 nF. Four are one per chip on its supply: 74HC08 and 74HC14
between their pins 14 and 7, on the 3.3 V, LM339 between its pins 3 and 12, on
the 5 V, and one on the ESP32-C6 board. The fifth is on GPIO3, towards ground,
on the fault line. There is none on the bridge module.

## Assembling the read front end

This is the procedure followed on 7 September 2026 for the comparator and the
sense resistors. All the assembly is done with the circuit off, supply
disconnected and USB cable unplugged.

1. Before anything else, with the multimeter and the circuit off, check that
   there is no continuity between the 5 V line and ground, and likewise
   between 3.3 V and ground.

2. Plug the socket across the centre channel of the breadboard, in a free area,
   with the reference notch facing up. Insert the LM339 in the socket following
   that notch.

3. A wire from pin 3 to the 5 V line. A wire from pin 12 to the star ground,
   the same used for everything else.

4. A 100 nF capacitor directly between pin 3 and pin 12, as short as possible.

5. Pick a free row of the breadboard: it will be the threshold node. From the
   5 V line, put a 22 kΩ and a 4.7 kΩ resistor in series, with the second one
   landing on that row.

6. From the same row, a 100 Ω resistor to ground.

7. From the threshold row, one wire to pin 5 and another to pin 7.

8. On each rail, break the direct link between the bridge output and the track
   and put two 4.7 Ω resistors in parallel in its place, so that the current
   from the bridge output to the rail has to pass through them.

9. Across each pair, two 1N5819 diodes facing opposite ways: the first with its
   band towards the track side, the second with its band towards the bridge
   side.

10. From the track-side node of the first pair, not the bridge side, a 1 kΩ
   resistor to pin 4. From the track-side node of the second pair, a 1 kΩ
   resistor to pin 6.

11. Join pin 1 and pin 2, which are adjacent, with a short wire. The two
    outputs work together: the one that sees current pulls the common wire
    down, the other watches.

12. From that common node, a 1 kΩ resistor to the **3.3 V** line, 3.3 and not
    five. This resistor sets the high level, and it is the reason the board pin
    will never see more than 3.3 V.

13. From the same common node, the wire to GPIO5 on the board.

14. Repeat the check of step 1 and add two more: that pin 3 is not in contact
    with ground, and that the common output node is not either.

**Two things not to get wrong.** The signal inputs are pins 4 and 6, the
threshold goes to pins 5 and 7; swapped, the circuit works backwards and the
board's serial port understands nothing. The resistor of step 12 goes to 3.3 V;
taking it to five by mistake sends five volts into a pin rated for 3.3.

## Open bug: the fault with two locomotives

Since 10 September 2026, with two locomotives on the track, the short-circuit
detector trips 17 milliseconds after the track is powered. With a single
locomotive the bench starts cleanly. The log puts the power at 5.537 s and the
short at 5.663 s, and the detector needs fifteen low samples out of twenty at
one millisecond, so the line stays low for the whole window. The bench supply
reads 0.08 A, which is no short at all.

The lead to follow is the inrush that charges the capacitors of the
two decoders: the bridge sees an overcurrent, retries every few milliseconds,
and FAULT pulses long enough for the detector to call it a short. The
measurement agreed for this, still to be done, is one probe on GPIO3 and one on
a rail at 5 ms per division, triggered on the falling edge of GPIO3, powering up
with both locomotives. A burst of pulses on FAULT while the waveform on the
rail breaks up means inrush; a single fall that stays down means something else.

Worth keeping in mind while reading the capture: GPIO3 carries a capacitor to
ground and is held up only by the weak pull-up inside the chip, so the line
rises slowly. A FAULT that pulses briefly can therefore look, on the pin, like
a line that stays down, and that alone could be enough to make the detector
call a short where there is none.

## What is no longer there

The H-bridge of the first build, the two TLV3501 comparators, the external
terminator with the IRLZ44N MOSFETs and their burden resistors, and the 74HC14
inverter on the board's serial input, which served an earlier front end and is
now replaced by the pull-up to 3.3 V.
