cc90202/DCC-esp32/hardware/pcb/dcc-station.kicad_pcb

## KiCad design hardware/pcb/dcc-station.kicad_pcb (2026-10-24)

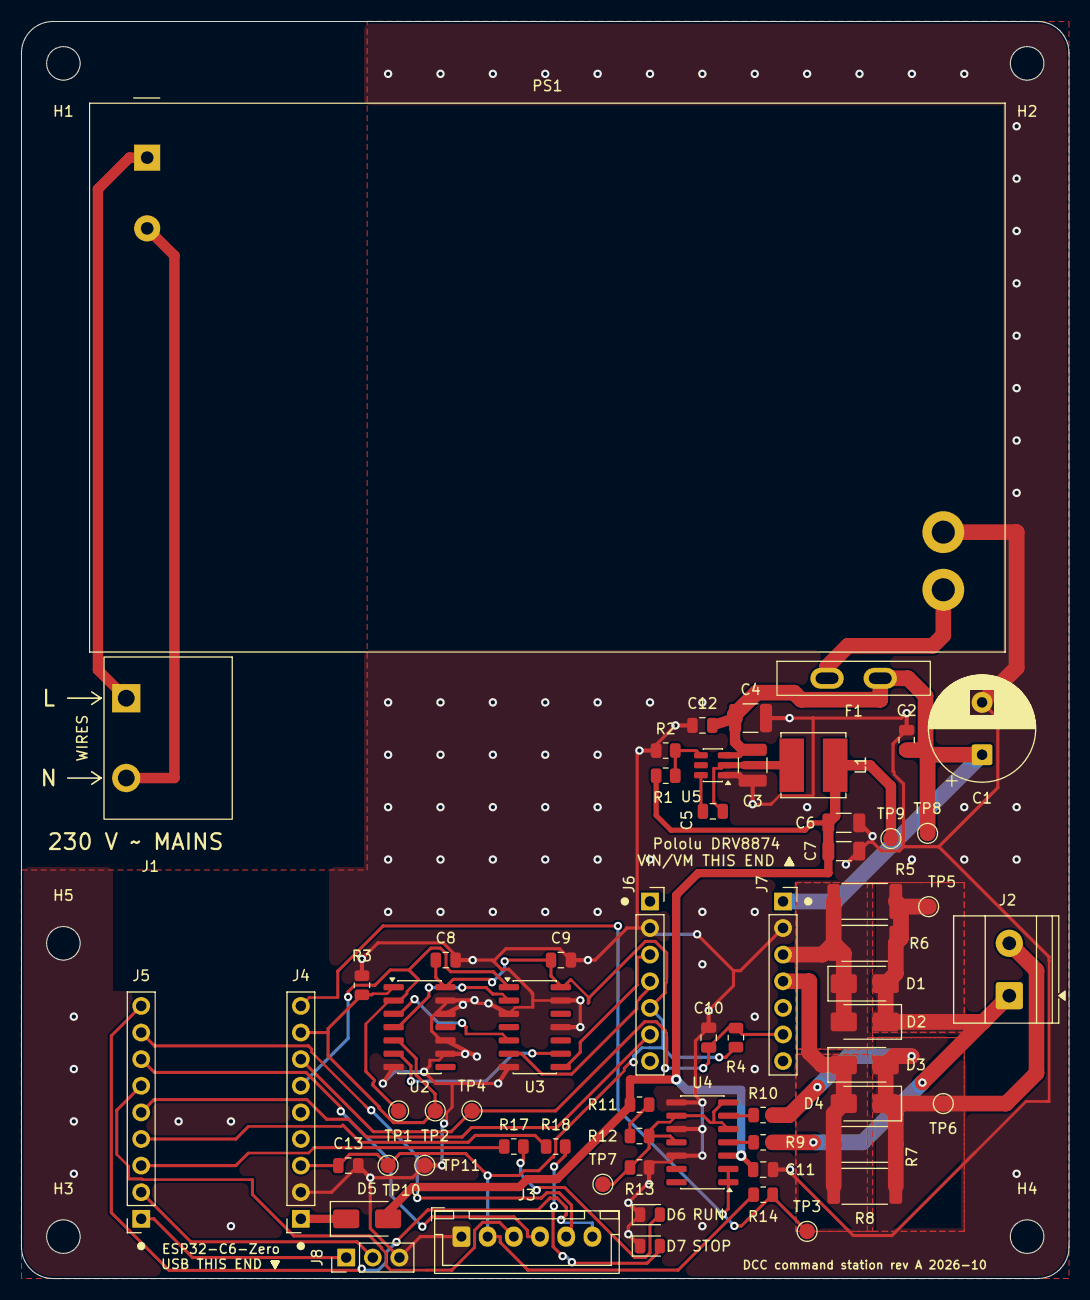
[picture p6: board dcc-station.kicad_pcb from above]

Board: 2 copper layers, 100.0 x 120.0 mm, 67 parts (0 on the bottom side), 39 nets.

Parts:
C1: 470uF 25V; CP_Radial_D10.0mm_P5.00mm
C2, C5, C8, C9, C10, C11, C12, C13: 100nF 50V X7R; C_0805_2012Metric
C3, C4: 10uF 50V X7R; C_1210_3225Metric
C6, C7: 22uF 25V; C_1206_3216Metric
D1, D2, D3, D4: SS34; D_SMA
D5: SS14; D_SMA
D6: LED green 0805; LED_0805_2012Metric
D7: LED red 0805; LED_0805_2012Metric
F1: MF-R400 4A 30V; Polyfuse_Radial_P5.08mm_W14.5mm
H1, H2, H3, H4, H5: M3; MountingHole_3.2mm_M3
J1: MAINS L N 7.62mm; TerminalBlock_7.62mm_1x02
J2: TRACK; TerminalBlock_Phoenix_MKDS-1,5-2_1x02_P5.00mm_Horizontal
J3: PANEL; JST_XH_B6B-XH-A_1x06_P2.50mm_Vertical
J4: ESP32-C6-Zero left row; PinSocket_1x09_P2.54mm_Vertical
J5: ESP32-C6-Zero right row; PinSocket_1x09_P2.54mm_Vertical
J6: Pololu DRV8874 #4035 left row; PinSocket_1x07_P2.54mm_Vertical
J7: Pololu DRV8874 #4035 right row; PinSocket_1x07_P2.54mm_Vertical
J8: SERIAL TX RX GND; PinHeader_1x03_P2.54mm_Vertical
L1: 10uH 3A; L_Bourns_SRN6045TA
PS1: IRM-45-15; Converter_ACDC_MeanWell_IRM-60-xx_THT
R1: 100k 1%; R_0805_2012Metric
R2: 13.7k 1%; R_0805_2012Metric
R3: 100k; R_0805_2012Metric
R4: 10k; R_0805_2012Metric
R5, R6, R7, R8: 4.7R 1W; R_2512_6332Metric
R9, R10, R14: 1k; R_0805_2012Metric
R11: 22k; R_0805_2012Metric
R12: 4.7k; R_0805_2012Metric
R13: 100R; R_0805_2012Metric
R17, R18: 470R; R_0805_2012Metric
TP1: TP1; TestPoint_Pad_D1.5mm
TP2: TP2; TestPoint_Pad_D1.5mm
TP3: TP3; TestPoint_Pad_D1.5mm
TP4: TP4; TestPoint_Pad_D1.5mm
TP5: TP5; TestPoint_Pad_D1.5mm
TP6: TP6; TestPoint_Pad_D1.5mm
TP7: TP7; TestPoint_Pad_D1.5mm
TP8: TP8; TestPoint_Pad_D1.5mm
TP9: TP9; TestPoint_Pad_D1.5mm
TP10: TP10; TestPoint_Pad_D1.5mm
TP11: TP11; TestPoint_Pad_D1.5mm
U2: 74HC08; SOIC-14_3.9x8.7mm_P1.27mm
U3: 74HC14; SOIC-14_3.9x8.7mm_P1.27mm
U4: LM339; SOIC-14_3.9x8.7mm_P1.27mm
U5: TPS54302; TSOT-23-6

Connections:
+3V3: C8.1, C9.1, C13.1, J3.2, J4.3, J6.5, R4.1, R14.1, TP10.1, U2.14, U3.14
+5V: C6.1, C7.1, C11.1, D5.2, L1.2, R1.1, R11.1, TP9.1, U4.3
+5V_ESP: D5.1, J4.1
+15V: C1.1, C2.1, C3.1, C4.1, C12.1, F1.2, J7.1, TP8.1, U5.3
+15V_RAW: F1.1, PS1.3
AC_L: J1.1, PS1.1
AC_N: J1.2, PS1.2
AND1: U2.3, U3.5
AND2: U2.6, U3.9
BOOT: C5.1, U5.6
CMP_INA: R9.2, U4.4
CMP_INB: R10.2, U4.6
DCC_INV: U2.4, U3.2
FB: R1.2, R2.1, U5.4
GND: C1.2, C2.2, C3.2, C4.2, C6.2, C7.2, C8.2, C9.2, C10.2, C11.2, C12.2, C13.2, D6.1, D7.1, J3.1, J4.2, J6.2, J7.2, J8.3, PS1.4, R2.2, R3.2, R13.2, TP11.1, U2.7, U2.9, U2.10, U2.12, U2.13, U3.3, U3.7, U3.11, U3.13, U4.8, U4.10, U4.12, U5.1
GPIO2: J4.6, TP1.1, U2.2, U3.1
GPIO3: C10.1, J4.7, J7.6, R4.2, TP4.1
GPIO4: J4.8, R3.1, TP2.1, U2.1, U2.5
GPIO14: J5.3, R17.1
GPIO15: J5.4, R18.1
GPIO18: J5.5, J6.6
GPIO19: J3.3, J5.6
GPIO20: J3.4, J5.7
GPIO21: J3.5, J5.8
GPIO22: J3.6, J5.9
IN1: J6.3, U3.8
IN2: J6.4, U3.6
LED_GREEN: D6.2, R17.2
LED_RED: D7.2, R18.2
OUT1: D1.1, D2.2, J7.3, R5.1, R6.1
OUT2: D3.1, D4.2, J7.4, R7.1, R8.1
RAILCOM_RX: J4.9, R14.2, TP3.1, U4.1, U4.2
SENSE_A: D1.2, D2.1, J2.1, R5.2, R6.2, R9.1, TP5.1
SENSE_B: D3.2, D4.1, J2.2, R7.2, R8.2, R10.1, TP6.1
SW: C5.2, L1.1, U5.2
UART0_RX: J5.2, J8.2
UART0_TX: J5.1, J8.1
VTH: R12.2, R13.1, TP7.1, U4.5, U4.7, U4.9, U4.11
VTH_MID: R11.2, R12.1
