cc90202/DCC-esp32/src/railcom/runtime_dispatch.rs

//! Runtime routing for parsed RailCom UART windows.
//!
//! The boot layer wires UART hardware and channels; this module owns the
//! application-level routing of decoded RailCom windows to loco tracking,
//! logon handling, and POM response attribution.

use defmt::{info, warn};

use crate::cutout::LogonCommand;
use crate::dcc::PomRailcomResult;
#[cfg(feature = "dcc-a")]
use crate::dcc::SchedulerCommand;
use crate::dcc::cv::channels::PomRailcomResultSender;
use crate::dcc::scheduler::channels::SchedulerCommandSender;
#[cfg(feature = "dcc-a")]
use crate::dcc::{DecoderUid, LogonAnswer};
use crate::macros::bench_diag;
use crate::railcom::loco_tracker::{FragmentWindow, RailcomLocoSighting};
use crate::railcom::parser::{LogonPairing, ParseError, RailcomLogonResponse};
use crate::railcom::pipeline::{
    RailcomRxResult, record_pom_result_dropped, record_pom_result_forwarded, rx_overflow_total,
};
use crate::railcom::pom_dispatch::evaluate_pom_window;
use crate::railcom::uart_reader::{RailcomRxOutput, RailcomRxOutputReceiver};
use crate::railcom::{PacketSequence, RailcomChannel, RailcomItem};
use crate::track_output::RailcomPacketMetadata;

#[derive(Default)]
struct LogonDispatchState {
    logon_pairing: LogonPairing,
    /// [`rx_overflow_total`] when the last window was dispatched.
    overflows_seen: u32,
    /// Windows still to dispatch that may predate a lost one.
    suspect_windows: usize,
}

/// Windows that can be on their way to dispatch when the capture side counts
/// a loss: the full queue, plus the one the capture task is sending.
const WINDOWS_IN_FLIGHT: usize = crate::railcom::uart_reader::RX_WINDOW_DEPTH + 1;

impl LogonDispatchState {
    /// A window lost on the way breaks the run of consecutive windows that
    /// pairs address fragments (RCN-217 §4).
    ///
    /// The loss is counted when it happens, while windows captured before it
    /// may still wait in the queue. None of those may hand a high fragment to
    /// one captured after the loss, so the held fragment is dropped before
    /// each of them.
    fn forget_fragment_across_lost_windows(&mut self) {
        let overflows = rx_overflow_total();
        if overflows != self.overflows_seen {
            self.overflows_seen = overflows;
            self.suspect_windows = WINDOWS_IN_FLIGHT;
        }
        if self.suspect_windows > 0 {
            self.suspect_windows -= 1;
            crate::railcom::loco_tracker::forget_pending_fragment();
        }
    }
}

/// Tells the scheduler, which owns the decoder table, what came back after a
/// logon command.
///
/// An answer that cannot be queued is not retried here: the table gives up
/// waiting on its own and sends the command again.
#[cfg(feature = "dcc-a")]
fn report_logon_answer(answer: LogonAnswer, scheduler_sender: SchedulerCommandSender) {
    if scheduler_sender
        .try_send(SchedulerCommand::LogonAnswer(answer))
        .is_err()
    {
        warn!("railcom logon answer: scheduler channel full");
    }
}

#[cfg(feature = "dcc-a")]
fn dispatch_logon_response(
    packet_sequence: PacketSequence,
    response: RailcomLogonResponse,
    scheduler_sender: SchedulerCommandSender,
) {
    let answer = match response {
        RailcomLogonResponse::DecoderId(logon_id) => LogonAnswer::Announced(DecoderUid {
            manufacturer_id: logon_id.manufacturer_id,
            decoder_id: logon_id.decoder_id,
        }),
        RailcomLogonResponse::Select(logon_select) => {
            // The address the decoder asks for is on the track either way:
            // its own, or another locomotive's when the two collide.
            let sighting = crate::railcom::loco_tracker::record_identified_address(
                packet_sequence,
                logon_select.address,
            );
            log_first_sighting("railcom logon address", sighting);
            LogonAnswer::WantsAddress(logon_select.address)
        }
        RailcomLogonResponse::DecoderState(_) => LogonAnswer::Confirmed,
    };
    report_logon_answer(answer, scheduler_sender);
}

/// Without the `dcc-a` feature no logon answer is read, so none reaches
/// this point.
#[cfg(not(feature = "dcc-a"))]
fn dispatch_logon_response(
    _packet_sequence: PacketSequence,
    _response: RailcomLogonResponse,
    _scheduler_sender: SchedulerCommandSender,
) {
}

/// Reports a logon cutout that closed without a readable answer: a select
/// or assign is sent again, and an unreadable answer to a logon enable is
/// two decoders talking together.
///
/// Silence after a logon enable is the normal case and is not reported.
#[cfg(feature = "dcc-a")]
fn report_unreadable_logon_answer(
    command: LogonCommand,
    channel: RailcomChannel,
    answer: Option<&Result<RailcomLogonResponse, ParseError>>,
    scheduler_sender: SchedulerCommandSender,
) {
    if channel != RailcomChannel::Channel2 {
        return;
    }
    let report = match (command, answer) {
        (LogonCommand::Select | LogonCommand::Assign, None | Some(Err(_))) => {
            LogonAnswer::Unanswered(command)
        }
        (LogonCommand::Enable, Some(Err(error))) if error.is_logon_collision() => {
            LogonAnswer::Collided
        }
        _ => return,
    };
    report_logon_answer(report, scheduler_sender);
}

/// Bench diagnostic: what came back after a logon command and was not its
/// answer. Compiled out unless `bench-diag` is enabled: a decoder without
/// DCC-A may talk in these cutouts at every logon enable.
#[cfg_attr(
    not(feature = "bench-diag"),
    expect(
        unused_variables,
        reason = "the diagnostic macro removes its arguments when bench diagnostics are disabled"
    )
)]
fn log_rejected_logon_answer(result: &RailcomRxResult, command: LogonCommand, error: ParseError) {
    bench_diag! {
        info!(
            "railcom logon answer rejected: command={:?} error={:?} raw={=[u8]:#04x} packet={}",
            command,
            error,
            result.window.raw_slice(),
            result.window.packet_sequence,
        );
    }
}

fn log_first_sighting(prefix: &str, sighting: RailcomLocoSighting) {
    // Repeats are hot-path telemetry covered by aggregate counters; only the
    // first sighting is a state transition worth logging.
    if sighting.seen_count == 1 {
        info!(
            "{}: addr={} kind={:?} packet={}",
            prefix,
            sighting.address.value(),
            sighting.address.kind(),
            sighting.packet_sequence,
        );
    }
}

fn record_loco_sighting(
    result: &RailcomRxResult,
    packet_metadata: Option<RailcomPacketMetadata>,
    complete_items: &[RailcomItem],
) {
    let window = match (result.window.channel, packet_metadata) {
        (RailcomChannel::Channel2, _) => FragmentWindow::Channel2,
        (RailcomChannel::Channel1, None) => FragmentWindow::UnknownChannel1,
        (RailcomChannel::Channel1, Some(metadata)) if metadata.target_address.is_some() => {
            FragmentWindow::LocoChannel1
        }
        (RailcomChannel::Channel1, Some(_)) => FragmentWindow::OtherChannel1,
    };
    let direct_sighting = crate::railcom::loco_tracker::record_loco_identification(
        result.window.packet_sequence,
        window,
        complete_items,
    );
    let target_sighting = direct_sighting.or_else(|| {
        packet_metadata
            .and_then(|metadata| metadata.target_address)
            .and_then(|target| {
                crate::railcom::loco_tracker::record_target_from_matching_address_fragment(
                    result.window.packet_sequence,
                    target,
                    complete_items,
                )
            })
    });

    if let Some(sighting) = target_sighting {
        log_first_sighting("railcom loco identified", sighting);
    }
}

fn forward_pom_result(
    result: &RailcomRxResult,
    packet_metadata: Option<RailcomPacketMetadata>,
    complete_items: &[RailcomItem],
    pom_result_sender: PomRailcomResultSender,
) {
    let pom_result = evaluate_pom_window(
        result.window.packet_sequence,
        result.window.channel,
        packet_metadata,
        complete_items,
    );
    log_pom_window(result, packet_metadata, complete_items, pom_result.as_ref());
    let Some(pom_result) = pom_result else {
        return;
    };

    if pom_result_sender.try_send(pom_result).is_ok() {
        record_pom_result_forwarded();
    } else {
        record_pom_result_dropped();
    }
}

/// Bench diagnostic: every channel-2 window of a POM cutout, with what the
/// parser made of it and what reached the POM actor. The periodic raw dump
/// samples one window in a hundred, which never shows the windows of a
/// read that times out.
///
/// Compiled out unless `bench-diag` is enabled. This one is unthrottled and
/// fires during the very reads whose cutout timing we measure, and a defmt
/// line holds a critical section for its whole duration.
#[cfg_attr(
    not(feature = "bench-diag"),
    expect(
        unused_variables,
        reason = "the diagnostic macro removes its arguments when bench diagnostics are disabled"
    )
)]
fn log_pom_window(
    result: &RailcomRxResult,
    packet_metadata: Option<RailcomPacketMetadata>,
    complete_items: &[RailcomItem],
    pom_result: Option<&PomRailcomResult>,
) {
    bench_diag! {
        use crate::cutout::CutoutMode;

        let Some(metadata) = packet_metadata else {
            return;
        };
        if result.window.channel != RailcomChannel::Channel2
            || !matches!(metadata.cutout, CutoutMode::PomRead | CutoutMode::PomWrite)
        {
            return;
        }
        let (value, ack, nack) = match pom_result {
            Some(PomRailcomResult::Window {
                value, ack, nack, ..
            }) => (*value, *ack, *nack),
            _ => (None, false, false),
        };
        // A busy reply yields no verdict, so without this it would read exactly
        // like a window that answered nothing at all.
        let busy = complete_items.contains(&RailcomItem::Busy);
        info!(
            "railcom pom ch2 seq={} req={:?} raw={=[u8]:#04x} outcome={:?} items={} value={:?} ack={} nack={} busy={}",
            result.window.packet_sequence.value(),
            metadata.pom_request_id,
            result.window.raw_slice(),
            result.outcome,
            complete_items.len(),
            value,
            ack,
            nack,
            busy
        );
    }
}

/// Logon command whose answer this window may hold.
///
/// Always none without the `dcc-a` feature (see `Cargo.toml`): no logon
/// answer is read, so no Select goes out.
fn logon_command(packet_metadata: Option<RailcomPacketMetadata>) -> LogonCommand {
    match packet_metadata {
        Some(metadata) if cfg!(feature = "dcc-a") => metadata.logon,
        _ => LogonCommand::None,
    }
}

fn dispatch_processed_window(
    state: &mut LogonDispatchState,
    result: &RailcomRxResult,
    pom_result_sender: PomRailcomResultSender,
    scheduler_sender: SchedulerCommandSender,
) {
    let complete_items = result.complete_items();
    let packet_metadata =
        crate::track_output::railcom_packet_metadata(result.window.packet_sequence);

    state.forget_fragment_across_lost_windows();
    let command = logon_command(packet_metadata);
    let logon_answer = state.logon_pairing.observe(
        command,
        result.window.packet_sequence,
        result.window.channel,
        result.window.raw_slice(),
    );
    #[cfg(feature = "dcc-a")]
    report_unreadable_logon_answer(
        command,
        result.window.channel,
        logon_answer.as_ref(),
        scheduler_sender,
    );
    // A window that completes a logon answer carries a decoder identity, not
    // address datagrams, even when its symbols also parse as an address pair.
    match logon_answer {
        Some(Ok(response)) => {
            dispatch_logon_response(result.window.packet_sequence, response, scheduler_sender);
        }
        Some(Err(error)) => {
            log_rejected_logon_answer(result, command, error);
            record_loco_sighting(result, packet_metadata, complete_items);
        }
        None => record_loco_sighting(result, packet_metadata, complete_items),
    }

    forward_pom_result(result, packet_metadata, complete_items, pom_result_sender);
}

#[embassy_executor::task]
pub async fn railcom_uart_runtime_dispatch_task(
    receiver: RailcomRxOutputReceiver,
    pom_result_sender: PomRailcomResultSender,
    scheduler_sender: SchedulerCommandSender,
) -> ! {
    let mut state = LogonDispatchState::default();

    loop {
        match receiver.receive().await {
            RailcomRxOutput::WindowProcessed(result) => {
                dispatch_processed_window(&mut state, &result, pom_result_sender, scheduler_sender);
            }
            RailcomRxOutput::WindowError(err) => {
                warn!("railcom rx window assembly: {:?}", err);
            }
        }
    }
}
