cc90202/DCC-esp32/src/dcc/engine.rs

//! DCC engine feeder for the ISR-driven RMT backend.

use crate::dcc::channels::{DccFrameReceiver, PowerFenceAckSender};
use crate::dcc::timing::{IDLE_RMT_SIZE, RMT_CLOCK_HZ};
use crate::dcc::{DccPacket, encode_dcc_packet};
use crate::macros::bench_diag;
use crate::rmt_dcc as rmt_driver;
use crate::station_status::{FaultCause, FaultEvent};
use crate::system_status::channels::FaultEventSender;
use dcc_protocol::encoder::{EncodeError, PulseCode as DccPulseCode, encode_dcc_data_portion};
use dcc_protocol::timing::MAX_DATA_PULSES;

use embassy_time::{Duration, Instant, Timer, with_timeout};
use esp_hal::gpio::Level;
use esp_hal::rmt::PulseCode;
use heapless::Vec;

const _: () = assert!(
    RMT_CLOCK_HZ == 1_000_000,
    "RMT_CLOCK_HZ must be 1MHz for direct microsecond-to-tick conversion"
);

const ISR_WATCHDOG_TIMEOUT: Duration = Duration::from_millis(50);
const ISR_RESET_GRACE_PERIOD: Duration = Duration::from_millis(100);

/// Pre-encoded idle waveform used to bootstrap continuous RMT loop mode.
pub(crate) type IdleRmtBuffer = Vec<PulseCode, IDLE_RMT_SIZE>;

/// Errors while preparing the pre-encoded idle waveform.
#[derive(Debug, Clone, Copy, PartialEq, Eq)]
#[cfg_attr(target_arch = "riscv32", derive(defmt::Format))]
pub(crate) enum IdleWaveformBuildError {
    PacketEncoding,
    BufferOverflow,
}

impl core::fmt::Display for IdleWaveformBuildError {
    fn fmt(&self, formatter: &mut core::fmt::Formatter<'_>) -> core::fmt::Result {
        match self {
            Self::PacketEncoding => formatter.write_str("idle DCC packet encoding failed"),
            Self::BufferOverflow => formatter.write_str("idle RMT waveform buffer overflow"),
        }
    }
}

impl core::error::Error for IdleWaveformBuildError {}

/// Errors while converting one DCC packet into the RMT data buffer.
#[derive(Debug, Clone, Copy, PartialEq, Eq)]
#[cfg_attr(target_arch = "riscv32", derive(defmt::Format))]
enum EngineEncodeError {
    Dcc(EncodeError),
    RmtBufferOverflow,
}

struct EncodedRmtPacket {
    data: Vec<PulseCode, MAX_DATA_PULSES>,
    dcc_duration_us: u32,
}

/// Build the pre-encoded idle waveform used to bootstrap the continuous loop.
pub(crate) fn build_idle_rmt_buffer() -> Result<IdleRmtBuffer, IdleWaveformBuildError> {
    let idle_packet = DccPacket::Idle;
    let idle_pulses =
        encode_dcc_packet(&idle_packet).map_err(|_| IdleWaveformBuildError::PacketEncoding)?;
    let mut buf: IdleRmtBuffer = Vec::new();
    for pulse in &idle_pulses {
        let rmt_pulse = convert_pulse_to_rmt(pulse);
        buf.push(rmt_pulse)
            .map_err(|_| IdleWaveformBuildError::BufferOverflow)?;
    }
    buf.push(PulseCode::end_marker())
        .map_err(|_| IdleWaveformBuildError::BufferOverflow)?;
    Ok(buf)
}

/// Pure async feeder paced by the ISR ACK.
pub(crate) async fn dcc_engine_task(
    receiver: DccFrameReceiver,
    fault_sender: FaultEventSender,
    fence_ack_sender: PowerFenceAckSender,
) -> ! {
    defmt::info!("DCC engine feeder started");

    let mut last_heartbeat = rmt_driver::isr_heartbeat();
    let mut last_progress = Instant::now();
    let mut last_ota_stall_log = None;

    loop {
        while !rmt_driver::is_consumed() {
            let heartbeat = rmt_driver::isr_heartbeat();
            if heartbeat != last_heartbeat {
                last_heartbeat = heartbeat;
                last_progress = Instant::now();
                crate::liveness::beat(crate::liveness::Task::Dcc);
            }

            // Sleep until the ISR consumes the slot, but keep the original
            // heartbeat-based watchdog deadline instead of waiting forever.
            let elapsed = Instant::now().duration_since(last_progress);
            let remaining = ISR_WATCHDOG_TIMEOUT
                .checked_sub(elapsed)
                .unwrap_or(Duration::MIN);
            if with_timeout(remaining, rmt_driver::wait_for_packet_consumed())
                .await
                .is_ok()
            {
                continue;
            }

            // A timeout is fatal only when both the packet remains pending and
            // the ISR heartbeat failed to advance during the watchdog window.
            let heartbeat = rmt_driver::isr_heartbeat();
            if heartbeat != last_heartbeat {
                last_heartbeat = heartbeat;
                last_progress = Instant::now();
                crate::liveness::beat(crate::liveness::Task::Dcc);
            } else if !rmt_driver::is_consumed() {
                if crate::track_output::inhibited() && !crate::track_output::is_track_enabled() {
                    let now = Instant::now();
                    if last_ota_stall_log
                        .is_none_or(|last| now.duration_since(last) >= Duration::from_secs(5))
                    {
                        defmt::warn!("RMT watchdog: stall while the track is inhibited; waiting");
                        last_ota_stall_log = Some(now);
                    }
                    // The expired watchdog deadline must not become a busy
                    // loop during flash work. Do not claim DCC progress here.
                    Timer::after(ISR_WATCHDOG_TIMEOUT).await;
                    continue;
                }
                // Cut bridge power before logging, channel delivery or reset
                // grace time. A full fault queue must not keep the track live.
                if !crate::track_output::emergency_disable() {
                    defmt::error!("RMT watchdog: track output hardware unavailable");
                }
                defmt::error!(
                    "RMT ISR heartbeat stalled: heartbeat={}, idle_timeout_ms={}",
                    heartbeat,
                    ISR_WATCHDOG_TIMEOUT.as_millis()
                );
                if fault_sender
                    .try_send(FaultEvent::FaultLatched(FaultCause::Internal))
                    .is_err()
                {
                    defmt::error!("RMT watchdog: fault queue full; track disabled, resetting");
                }
                Timer::after(ISR_RESET_GRACE_PERIOD).await;
                crate::restart::restart();
            }
        }

        let frame = receiver.receive().await;
        bench_diag! {
            frame_queue_stats::record(frame, receiver.len());
        }
        if let Some(generation) = frame.fence_generation() {
            // The feeder only receives after the RMT slot is consumed, and the
            // fence was appended after every preceding scheduler frame.
            fence_ack_sender.send(generation).await;
            crate::liveness::beat(crate::liveness::Task::Dcc);
            continue;
        }
        let next_rmt = match encode_packet_to_rmt_data(&frame.packet()) {
            Ok(buf) => buf,
            Err(error) => {
                defmt::warn!("packet encoding failed, skipping: {:?}", error);
                continue;
            }
        };

        let cutout = frame.effective_cutout();
        if cutout != frame.cutout() {
            defmt::warn!("POM frame missing request id; transmitting without RailCom cutout");
        }
        rmt_driver::submit_packet(
            next_rmt.data.as_slice(),
            next_rmt.dcc_duration_us,
            cutout,
            frame.railcom_target_address(),
            frame.pom_request_id(),
            frame.packet().logon_command(),
        );
        crate::liveness::beat(crate::liveness::Task::Dcc);
    }
}

/// Bench diagnostic: how long frames wait between the scheduler picking them
/// and the engine taking them, and how close the queue comes to running dry.
///
/// A new command waits as long as any frame picked at the same moment, so the
/// longest wait is the delay a speed change or an emergency stop can see
/// before reaching the RMT driver. The lowest fill level after a take shows
/// how much of the queue depth the scheduler actually needs as a reserve.
#[cfg(feature = "bench-diag")]
pub(crate) mod frame_queue_stats {
    use core::sync::atomic::{AtomicU32, Ordering};

    use embassy_time::Instant;

    use crate::dcc::DccFrame;

    static WAIT_MAX_US: AtomicU32 = AtomicU32::new(0);
    static WAIT_TOTAL_US: AtomicU32 = AtomicU32::new(0);
    static FRAMES: AtomicU32 = AtomicU32::new(0);
    /// `u32::MAX` until a frame is taken in the current period.
    static LOWEST_FILL: AtomicU32 = AtomicU32::new(u32::MAX);
    static DRAINED: AtomicU32 = AtomicU32::new(0);

    /// Queue figures since the previous [`take`].
    #[derive(Debug, Clone, Copy, defmt::Format)]
    pub(crate) struct FrameQueueStats {
        pub wait_max_us: u32,
        pub wait_avg_us: u32,
        pub frames: u32,
        /// Frames still queued behind the one just taken, at the lowest.
        pub lowest_fill: Option<u32>,
        /// Takes that left the queue empty.
        pub drained: u32,
    }

    /// Frames the scheduler did not stamp (the boot sequence, power fences)
    /// are left out, so the boot burst does not read as a drained queue.
    pub(super) fn record(frame: DccFrame, queued_behind: usize) {
        let Some(picked_at) = frame.picked_at() else {
            return;
        };
        let wait_us =
            u32::try_from(Instant::now().duration_since(picked_at).as_micros()).unwrap_or(u32::MAX);
        let queued_behind = u32::try_from(queued_behind).unwrap_or(u32::MAX);
        WAIT_MAX_US.fetch_max(wait_us, Ordering::Relaxed);
        WAIT_TOTAL_US.fetch_add(wait_us, Ordering::Relaxed);
        FRAMES.fetch_add(1, Ordering::Relaxed);
        LOWEST_FILL.fetch_min(queued_behind, Ordering::Relaxed);
        if queued_behind == 0 {
            DRAINED.fetch_add(1, Ordering::Relaxed);
        }
    }

    /// Returns the figures of the period that ends now and starts a new one.
    #[must_use]
    pub(crate) fn take() -> FrameQueueStats {
        let frames = FRAMES.swap(0, Ordering::Relaxed);
        let wait_total_us = WAIT_TOTAL_US.swap(0, Ordering::Relaxed);
        FrameQueueStats {
            wait_max_us: WAIT_MAX_US.swap(0, Ordering::Relaxed),
            wait_avg_us: wait_total_us.checked_div(frames).unwrap_or(0),
            frames,
            lowest_fill: Some(LOWEST_FILL.swap(u32::MAX, Ordering::Relaxed))
                .filter(|&fill| fill != u32::MAX),
            drained: DRAINED.swap(0, Ordering::Relaxed),
        }
    }
}

fn encode_packet_to_rmt_data(packet: &DccPacket) -> Result<EncodedRmtPacket, EngineEncodeError> {
    let encoded = encode_dcc_data_portion(packet).map_err(EngineEncodeError::Dcc)?;
    let data =
        convert_to_rmt(&encoded.pulses).map_err(|()| EngineEncodeError::RmtBufferOverflow)?;
    Ok(EncodedRmtPacket {
        data,
        dcc_duration_us: encoded.dcc_duration_us,
    })
}

fn convert_pulse_to_rmt(pulse: &DccPulseCode) -> PulseCode {
    let level1 = if pulse.level1 {
        Level::High
    } else {
        Level::Low
    };
    let level2 = if pulse.level2 {
        Level::High
    } else {
        Level::Low
    };
    PulseCode::new(level1, pulse.length1, level2, pulse.length2)
}

fn convert_to_rmt(pulses: &[DccPulseCode]) -> Result<Vec<PulseCode, MAX_DATA_PULSES>, ()> {
    let mut buf = Vec::new();
    for pulse in pulses {
        buf.push(convert_pulse_to_rmt(pulse)).map_err(|_| ())?;
    }
    Ok(buf)
}

#[cfg(test)]
mod tests {
    use super::*;
    use dcc_protocol::timing::PREAMBLE_BITS;

    #[test]
    fn test_idle_waveform_layout_matches_fixed_preamble_design() {
        let idle = build_idle_rmt_buffer().unwrap();
        assert_eq!(idle.len(), IDLE_RMT_SIZE);
        assert_eq!(PREAMBLE_BITS, 20);
        assert_eq!(idle[IDLE_RMT_SIZE - 1], PulseCode::end_marker());
    }
}
