cc90202/DCC-esp32/crates/dcc-protocol/src/packet.rs

//! DCC packet types and byte encoding.
//!
//! Implements NMRA S-9.2 compliant DCC packet structures and binary encoding.
//!
//! Address, speed, service-mode CV, POM CV, and binary-state address fields use
//! validated newtypes so invalid ranges are rejected before packet construction.
//!
//! ```
//! use dcc_protocol::packet::{DccAddress, DccPacket, Direction};
//!
//! let addr = DccAddress::new_short(42).expect("42 is a valid short address");
//! let packet = DccPacket::speed_128step(addr, 75, Direction::Forward).unwrap();
//! let bytes = packet.to_bytes();
//! assert!(!bytes.is_empty());
//! ```
//!
//! # NMRA compliance
//!
//! - Short addresses: 1-127 (0 is broadcast only)
//! - Long addresses: 128-10239 (11-bit field)
//! - Speed28: 0=stop, 1=e-stop, then the logical steps
//!   `1..=`[`SpeedFormat::max_step`](crate::SpeedFormat::max_step) each one
//!   above its number (see
//!   [`NmraSpeed28`])
//! - Speed128: 0=stop, then the logical steps; the encoder skips wire value 1,
//!   which is the e-stop (see [`NmraSpeed128`])
//! - Service Mode CV range: 1-256 (Direct Mode addressing)
//! - POM CV range: 1-1024 (Long Form CV access)

mod address;
mod values;

use heapless::Vec;

use crate::function_groups::FunctionGroupKind;
pub use crate::speed28::NmraSpeed28;
use crate::speed28::encode_nmra_instruction_speed_bits;

pub use address::HighFragment;
pub use address::{DccAddress, DccAddressKind};
pub use values::{
    BinaryStateAddress, LogonGroup, LogonSessionId, NmraSpeed128, PomCv, ServiceModeCv,
};

/// Locomotive direction
#[derive(Debug, Clone, Copy, PartialEq, Eq)]
#[cfg_attr(feature = "defmt", derive(defmt::Format))]
pub enum Direction {
    /// Forward: the direction bit set.
    Forward,
    /// Reverse: the direction bit clear.
    Reverse,
}

/// DCC packet types
#[derive(Debug, Clone, Copy, PartialEq, Eq)]
pub enum DccPacket {
    /// Idle packet - keeps DCC signal active
    Idle,
    /// Reset packet - resets all decoders
    Reset,
    /// 28-speed step format with direction
    /// Per NMRA S-9.2, bit C is speed LSB (interleaved), NOT headlight.
    /// FL (headlight) travels in function group G1.
    Speed28 {
        /// Decoder addressed.
        address: DccAddress,
        /// Direction of travel.
        direction: Direction,
        /// Packet speed value, emergency stop included.
        speed: NmraSpeed28,
    },
    /// 128-speed step format (advanced operations)
    Speed128 {
        /// Decoder addressed.
        address: DccAddress,
        /// Direction of travel.
        direction: Direction,
        /// Speed step, 0 for stop.
        speed: NmraSpeed128,
    },
    /// Function group packet: the decoder's functions of one NMRA group.
    ///
    /// `bits` holds the group's data bits as laid out on the wire (see
    /// [`FunctionGroupKind`]); bits outside the group's data mask are
    /// ignored when encoding. Build it with [`DccPacket::function_group`].
    FunctionGroup {
        /// Decoder addressed.
        address: DccAddress,
        /// Function group carried.
        kind: FunctionGroupKind,
        /// The group's data bits.
        bits: u8,
    },
    /// Emergency stop for a specific decoder
    /// Encoding: address + 01DC0001 where C=0 (NMRA S-9.2 e-stop) + checksum
    EmergencyStop {
        /// Decoder addressed.
        address: DccAddress,
        /// Direction bit sent with the stop.
        direction: Direction,
    },
    /// Broadcast stop: stops all decoders' motors but preserves state
    /// Different from Reset: BroadcastStop only stops motors, Reset resets all decoder state
    /// Encoding: 0x00 (broadcast) + 01100001 (fwd e-stop, C=0) + checksum
    BroadcastStop,
    /// Broadcast feature expansion - binary state short packet.
    ///
    /// RailCom/DCC-A track search uses binary state address 2 with state=false
    /// to invite app:search feedback during the following cutout.
    BroadcastBinaryStateShort {
        /// Binary state addressed.
        bin_addr: BinaryStateAddress,
        /// State to set.
        state: bool,
    },
    /// RCN-218 automatic logon enable packet addressed to 254.
    ///
    /// `group` uses the RCN-218 two-bit value: 0=all, 1=loco, 2=accessory, 3=now.
    LogonEnable {
        /// Decoders invited to log on.
        group: LogonGroup,
        /// Identifier of this command station.
        command_station_id: u16,
        /// Current logon session.
        session_id: LogonSessionId,
    },
    /// RCN-218 automatic logon select packet addressed to 254.
    LogonSelect {
        /// Manufacturer of the decoder; the low 12 bits travel.
        manufacturer_id: u16,
        /// Unique identifier of the decoder.
        decoder_id: u32,
        /// RCN-218 select subcommand.
        subcommand: u8,
    },
    /// RCN-218 automatic logon assign packet addressed to 254.
    ///
    /// Registers the decoder under `address` for this session. The assignment
    /// is always temporary: the decoder's own CV1 or CV17/18 stay untouched.
    LogonAssign {
        /// Manufacturer of the decoder; the low 12 bits travel.
        manufacturer_id: u16,
        /// Unique identifier of the decoder.
        decoder_id: u32,
        /// Address the decoder answers to from now on.
        address: DccAddress,
    },
    /// Service Mode: Verify Byte (instruction 0b0111_01AA)
    /// Tests if CV equals a specific value (decoder ACKs if match)
    /// CV range: 1-256 (Direct Mode, single-byte addressing)
    ServiceModeVerifyByte {
        /// CV to compare.
        cv: ServiceModeCv,
        /// Value the CV is compared against.
        value: u8,
    },
    /// Service Mode: Write Byte (instruction 0b0111_11AA)
    /// Sets CV to a specific value (decoder ACKs on success)
    /// CV range: 1-256 (Direct Mode, single-byte addressing)
    ServiceModeWriteByte {
        /// CV to write.
        cv: ServiceModeCv,
        /// Value to write.
        value: u8,
    },
    /// Programming on the Main: Write Byte (Long Form CV Access).
    PomWriteByte {
        /// Decoder addressed.
        address: DccAddress,
        /// CV to write.
        cv: PomCv,
        /// Value to write.
        value: u8,
    },
    /// Programming on the Main: Read Byte via Verify Byte + RailCom feedback.
    PomReadByte {
        /// Decoder addressed.
        address: DccAddress,
        /// CV to read.
        cv: PomCv,
    },
}

/// Maximum number of bytes in an encoded DCC packet, including its checksum.
///
/// RCN-218 `LogonAssign` is the longest packet currently supported. The
/// standard allows up to 15 bytes, reached only by its `SET_DATA` command.
pub const DCC_MAX_PACKET_BYTES: usize = 11;

/// RCN-218 §3.6: the two top bits of the assigned address, `11` for an
/// assignment that leaves the decoder's own address CVs untouched.
const LOGON_ASSIGN_TEMPORARY: u8 = 0xC0;

/// Builder for DCC packet byte sequences with incremental XOR checksum.
struct PacketBytes {
    bytes: Vec<u8, DCC_MAX_PACKET_BYTES>,
    checksum: u8,
}

impl PacketBytes {
    fn new() -> Self {
        Self {
            bytes: Vec::new(),
            checksum: 0,
        }
    }

    #[expect(
        clippy::expect_used,
        reason = "every packet variant encodes to at most DCC_MAX_PACKET_BYTES; an overflow is an encoder bug"
    )]
    fn push(&mut self, byte: u8) {
        self.bytes
            .push(byte)
            .expect("packet payload must fit DCC_MAX_PACKET_BYTES");
        self.checksum ^= byte;
    }

    fn push_address(&mut self, address: DccAddress) {
        let address_bytes = address.to_bytes();
        for byte in address_bytes {
            self.push(byte);
        }
    }

    /// Starts an RCN-218 packet for one decoder: address 254, the instruction
    /// with the top four bits of the 12-bit manufacturer id, its low byte,
    /// and the 32-bit decoder id.
    fn push_logon_target(&mut self, instruction: u8, manufacturer_id: u16, decoder_id: u32) {
        let [manufacturer_high, manufacturer_low] = manufacturer_id.to_be_bytes();
        self.push(254);
        self.push(instruction | (manufacturer_high & 0x0F));
        self.push(manufacturer_low);
        for byte in decoder_id.to_be_bytes() {
            self.push(byte);
        }
    }

    /// Appends the Dallas/Maxim CRC8 of the bytes pushed so far.
    ///
    /// Used by RCN-218 automatic-logon packets of six or more bytes
    /// (`LogonSelect`, `LogonAssign`), which carry a CRC8 byte ahead of the
    /// usual trailing XOR checksum.
    fn push_crc8(&mut self) {
        let crc = crate::logon::crc8_dallas_maxim(&self.bytes);
        self.push(crc);
    }

    #[expect(
        clippy::expect_used,
        reason = "every packet variant encodes to at most DCC_MAX_PACKET_BYTES; an overflow is an encoder bug"
    )]
    fn finalize(mut self) -> Vec<u8, DCC_MAX_PACKET_BYTES> {
        self.bytes
            .push(self.checksum)
            .expect("packet checksum must fit DCC_MAX_PACKET_BYTES");
        self.bytes
    }
}

impl DccPacket {
    /// Address whose decoder may answer in the following RailCom cutout.
    #[must_use]
    pub const fn railcom_target_address(&self) -> Option<DccAddress> {
        match *self {
            Self::Speed28 { address, .. }
            | Self::Speed128 { address, .. }
            | Self::FunctionGroup { address, .. }
            | Self::EmergencyStop { address, .. }
            | Self::PomWriteByte { address, .. }
            | Self::PomReadByte { address, .. } => Some(address),
            Self::Idle
            | Self::Reset
            | Self::BroadcastStop
            | Self::BroadcastBinaryStateShort { .. }
            | Self::LogonEnable { .. }
            | Self::LogonSelect { .. }
            | Self::LogonAssign { .. }
            | Self::ServiceModeVerifyByte { .. }
            | Self::ServiceModeWriteByte { .. } => None,
        }
    }

    #[inline]
    fn bool_mask(value: bool, mask: u8) -> u8 {
        if value { mask } else { 0 }
    }

    #[inline]
    fn direction_mask(direction: Direction, mask: u8) -> u8 {
        Self::bool_mask(direction == Direction::Forward, mask)
    }

    fn encode_speed28_instruction(direction: Direction, speed: NmraSpeed28) -> u8 {
        // Instruction format: 01DCSSSS (NMRA S-9.2 §2.3.2.3)
        0b0100_0000
            | Self::direction_mask(direction, 0b0010_0000)
            | encode_nmra_instruction_speed_bits(speed)
    }

    fn encode_speed128_data(direction: Direction, speed: NmraSpeed128) -> u8 {
        let raw = speed.value();
        let wire_speed = if raw == 0 { 0 } else { raw + 1 };
        Self::direction_mask(direction, 0x80) | (wire_speed & 0x7F)
    }

    fn encode_emergency_stop_instruction(direction: Direction) -> u8 {
        // E-stop per NMRA S-9.2: 01DC0001 with C=0, SSSS=0001
        0b0100_0001 | Self::direction_mask(direction, 0b0010_0000)
    }

    /// Encodes a validated 1-based CV number into the two on-wire bytes used by
    /// Direct Mode (S-9.2.2) and POM (S-9.2.1) packets.
    fn encode_cv_addr(cv: u16, op_prefix: u8) -> (u8, u8) {
        let wire_cv = cv - 1;
        let cv_high = op_prefix | (((wire_cv >> 8) & 0b11) as u8);
        let cv_low = (wire_cv & 0xFF) as u8;
        (cv_high, cv_low)
    }

    /// Helper function for tests - create an idle packet.
    #[cfg(test)]
    pub fn idle() -> Self {
        Self::Idle
    }

    /// Create a function group packet for `address`.
    ///
    /// `bits` are the group's data bits as laid out on the wire; bits outside
    /// `kind`'s data mask are dropped so equal packets compare equal.
    #[must_use]
    pub const fn function_group(address: DccAddress, kind: FunctionGroupKind, bits: u8) -> Self {
        Self::FunctionGroup {
            address,
            kind,
            bits: bits & kind.data_mask(),
        }
    }

    /// Create a 28-step speed packet.
    ///
    /// Returns `None` if speed > 29 (NMRA S-9.2 §2.3.2.3).
    pub fn speed_28step(address: DccAddress, speed: u8, direction: Direction) -> Option<Self> {
        Some(Self::Speed28 {
            address,
            direction,
            speed: NmraSpeed28::new(speed)?,
        })
    }

    /// Create a 128-step speed packet.
    ///
    /// Returns `None` if speed > 126 (NMRA S-9.2.1).
    pub fn speed_128step(address: DccAddress, speed: u8, direction: Direction) -> Option<Self> {
        Some(Self::Speed128 {
            address,
            direction,
            speed: NmraSpeed128::new(speed)?,
        })
    }

    /// Encode packet to bytes with checksum.
    ///
    /// Returns a vector containing the complete DCC packet payload bytes
    /// followed by the error detection checksum byte. Every variant encodes:
    /// speed, address and CV ranges are enforced by the field newtypes.
    #[must_use]
    pub fn to_bytes(&self) -> Vec<u8, DCC_MAX_PACKET_BYTES> {
        let mut packet = PacketBytes::new();

        match *self {
            Self::Idle => {
                // Idle packet: {preamble} 0 11111111 0 00000000 0 EEEEEEEE 1
                packet.push(0xFF);
                packet.push(0x00);
            }
            Self::Reset => {
                // Reset packet: {preamble} 0 00000000 0 00000000 0 EEEEEEEE 1
                packet.push(0x00);
                packet.push(0x00);
            }
            Self::Speed28 {
                address,
                direction,
                speed,
            } => {
                packet.push_address(address);
                packet.push(Self::encode_speed28_instruction(direction, speed));
            }
            Self::Speed128 {
                address,
                direction,
                speed,
            } => {
                // Advanced operations instruction: 0x3F
                packet.push_address(address);
                packet.push(0x3F);
                packet.push(Self::encode_speed128_data(direction, speed));
            }
            Self::FunctionGroup {
                address,
                kind,
                bits,
            } => {
                let data = bits & kind.data_mask();
                packet.push_address(address);
                match kind {
                    FunctionGroupKind::G1 => packet.push(0b1000_0000 | data),
                    FunctionGroupKind::G2a => packet.push(0b1011_0000 | data),
                    FunctionGroupKind::G2b => packet.push(0b1010_0000 | data),
                    FunctionGroupKind::G3 => {
                        packet.push(0xDE);
                        packet.push(data);
                    }
                    FunctionGroupKind::G4 => {
                        packet.push(0xDF);
                        packet.push(data);
                    }
                }
            }
            Self::EmergencyStop { address, direction } => {
                packet.push_address(address);
                packet.push(Self::encode_emergency_stop_instruction(direction));
            }
            Self::BroadcastStop => {
                // Broadcast address 0x00 + forward e-stop
                packet.push(0x00);
                packet.push(Self::encode_emergency_stop_instruction(Direction::Forward));
            }
            Self::BroadcastBinaryStateShort { bin_addr, state } => {
                packet.push(0x00);
                packet.push(0xDD);
                packet.push(Self::bool_mask(state, 0x80) | bin_addr.value());
            }
            Self::LogonEnable {
                group,
                command_station_id,
                session_id,
            } => {
                packet.push(254);
                packet.push(0xFC | group.value());
                packet.push((command_station_id >> 8) as u8);
                packet.push((command_station_id & 0xFF) as u8);
                packet.push(session_id.value());
            }
            Self::LogonSelect {
                manufacturer_id,
                decoder_id,
                subcommand,
            } => {
                packet.push_logon_target(0xD0, manufacturer_id, decoder_id);
                packet.push(subcommand);
                packet.push_crc8();
            }
            Self::LogonAssign {
                manufacturer_id,
                decoder_id,
                address,
            } => {
                let [address_high, address_low] = crate::logon::encode_address(address);
                packet.push_logon_target(0xE0, manufacturer_id, decoder_id);
                packet.push(LOGON_ASSIGN_TEMPORARY | address_high);
                packet.push(address_low);
                packet.push_crc8();
            }
            Self::ServiceModeVerifyByte { cv, value } => {
                // Service Mode Verify Byte per NMRA S-9.2.2
                // Packet format: [preamble] 0 0111CCAA 0 AAAAAAAA 0 DDDDDDDD 0 [checksum] 1
                // Where:
                //   0111CCAA AAAAAAAA = CV address (Direct Mode, CC=00 for CV 1-256)
                //   DDDDDDDD = value to verify (0-255)
                //
                // For CV 1-256: CC=00 (bits 9-8), AA AAAAAAAA = bits 7-0
                // Instruction byte: 0b0111_01AA (bits 3-2 = 01 for Verify)
                let (cv_high, cv_low) = Self::encode_cv_addr(cv.value(), 0b0111_0100);
                packet.push(cv_high);
                packet.push(cv_low);
                packet.push(value);
            }
            Self::ServiceModeWriteByte { cv, value } => {
                // Service Mode Write Byte per NMRA S-9.2.2
                // Packet format: same as Verify, but instruction byte bits 3-2 = 11 (Write)
                // Instruction byte: 0b0111_11AA (bits 3-2 = 11 for Write)
                let (cv_high, cv_low) = Self::encode_cv_addr(cv.value(), 0b0111_1100);
                packet.push(cv_high);
                packet.push(cv_low);
                packet.push(value);
            }
            Self::PomWriteByte { address, cv, value } => {
                let (cv_high, cv_low) = Self::encode_cv_addr(cv.value(), 0b1110_1100);
                packet.push_address(address);
                packet.push(cv_high);
                packet.push(cv_low);
                packet.push(value);
            }
            Self::PomReadByte { address, cv } => {
                let (cv_high, cv_low) = Self::encode_cv_addr(cv.value(), 0b1110_0100);
                packet.push_address(address);
                packet.push(cv_high);
                packet.push(cv_low);
                packet.push(0x00);
            }
        }

        packet.finalize()
    }
}

#[cfg(test)]
mod tests;
