cc90202/DCC-esp32/src/railcom/isr_capture.rs

//! ISR-backed RailCom UART capture path.
//!
//! The active ESP32-C6 runtime uses the cutout ISR to delimit a UART1 FIFO
//! snapshot, then this task drains those snapshots into the normal RailCom
//! parser.
//!
//! Honesty note: this path does not detect UART framing errors or line
//! glitches. It only classifies a window as "oversized" when the captured
//! FIFO snapshot exceeds `MAX_RAILCOM_WINDOW_BYTES`, which is an overflow condition,
//! not evidence of corrupted data. If framing-error detection is ever needed,
//! it must be read from the UART1 hardware status/interrupt flags (e.g.
//! `RXFIFO_OVF`, parity/frame error bits) at capture time; no such logic
//! exists in this module today.

use core::sync::atomic::{AtomicBool, AtomicU8, AtomicU32, Ordering};

use embassy_sync::blocking_mutex::raw::CriticalSectionRawMutex;
use embassy_sync::channel::Receiver;
use esp_hal::Async;
use esp_hal::uart::UartRx;

use crate::macros::bench_diag;
use crate::railcom::pipeline::{
    MAX_RAILCOM_WINDOW_BYTES, RailcomRxWindow, RailcomRxWindowError, process_rx_window,
    record_oversized_window, record_rx_overflows,
};
use crate::railcom::uart_reader::{RailcomRxOutput, RailcomRxOutputSender, RailcomUartWindowError};
use crate::railcom::{PacketSequence, RailcomChannel};

const CAPTURE_RING_CAPACITY: usize = 64;

static CAPTURE_WRITE_COUNT: AtomicU32 = AtomicU32::new(0);
static CAPTURE_READY: AtomicBool = AtomicBool::new(false);
static CAPTURE_GENERATIONS: [AtomicU32; CAPTURE_RING_CAPACITY] =
    [const { AtomicU32::new(0) }; CAPTURE_RING_CAPACITY];
/// Write count of the window each slot holds, so a reader that the ISR lapped
/// sees that the slot now holds a later window.
static CAPTURE_POSITIONS: [AtomicU32; CAPTURE_RING_CAPACITY] =
    [const { AtomicU32::new(0) }; CAPTURE_RING_CAPACITY];
static CAPTURE_SEQUENCES: [AtomicU32; CAPTURE_RING_CAPACITY] =
    [const { AtomicU32::new(0) }; CAPTURE_RING_CAPACITY];
static CAPTURE_CHANNELS: [AtomicU8; CAPTURE_RING_CAPACITY] =
    [const { AtomicU8::new(0) }; CAPTURE_RING_CAPACITY];
static CAPTURE_LENS: [AtomicU8; CAPTURE_RING_CAPACITY] =
    [const { AtomicU8::new(0) }; CAPTURE_RING_CAPACITY];
static CAPTURE_BYTES: [[AtomicU8; MAX_RAILCOM_WINDOW_BYTES]; CAPTURE_RING_CAPACITY] =
    [const { [const { AtomicU8::new(0) }; MAX_RAILCOM_WINDOW_BYTES] }; CAPTURE_RING_CAPACITY];

type CaptureNotifyChannel = embassy_sync::channel::Channel<CriticalSectionRawMutex, u8, 1>;
static CAPTURE_NOTIFY: CaptureNotifyChannel = CaptureNotifyChannel::new();

#[derive(Debug, Clone, Copy, PartialEq, Eq)]
struct CapturedWindow {
    packet_sequence: PacketSequence,
    channel: RailcomChannel,
    len: usize,
    bytes: [u8; MAX_RAILCOM_WINDOW_BYTES],
}

struct RailcomIsrCaptureUart {
    _uart_rx: UartRx<'static, Async>,
}

impl RailcomIsrCaptureUart {
    /// # Panics
    ///
    /// Panics if called more than once: this type owns the sole UART1 RX
    /// data path (see the SAFETY comments on the ISR-side register helpers
    /// below), so a second instance would race the first over FIFO access.
    /// Mirrors the double-init guard in `TrackOutput::new`.
    fn new(uart_rx: UartRx<'static, Async>) -> Self {
        let was_ready = CAPTURE_READY.swap(true, Ordering::AcqRel);
        assert!(
            !was_ready,
            "RailcomIsrCaptureUart must be initialized only once"
        );
        Self { _uart_rx: uart_rx }
    }
}

/// GPIO matrix input signal index of U1RXD on the ESP32-C6.
#[cfg_attr(
    not(feature = "bench-diag"),
    expect(dead_code, reason = "used only by the optional UART bench snapshot")
)]
const U1RXD_SIGNAL: usize = 9;
#[inline(always)]
fn uart1_rx_fifo_count() -> Option<u16> {
    if !CAPTURE_READY.load(Ordering::Acquire) {
        return None;
    }
    // SAFETY: `RailcomIsrCaptureUart` consumes the HAL UART1 RX owner before
    // setting CAPTURE_READY. After that, this module is the only UART1 RX
    // data path. The ISR-side helpers touch the RX FIFO data/count registers
    // and (in `uart1_reset_rx_fifo`) the `conf0.rxfifo_rst` control bit that
    // resets that same FIFO; no other UART1 register is written.
    let regs = unsafe { &*esp_hal::peripherals::UART1::ptr() };
    Some(u16::from(regs.status().read().rxfifo_cnt().bits()))
}

#[inline(always)]
fn uart1_read_byte() -> Option<u8> {
    if !CAPTURE_READY.load(Ordering::Acquire) {
        return None;
    }
    // SAFETY: same UART1 ownership invariant as `uart1_rx_fifo_count`.
    let regs = unsafe { &*esp_hal::peripherals::UART1::ptr() };
    Some(regs.fifo().read().rxfifo_rd_byte().bits())
}

#[inline(always)]
fn uart1_reset_rx_fifo() {
    if !CAPTURE_READY.load(Ordering::Acquire) {
        return;
    }
    // SAFETY: same UART1 ownership invariant as `uart1_rx_fifo_count`.
    let regs = unsafe { &*esp_hal::peripherals::UART1::ptr() };
    // On the ESP32-C6 `conf0` is a synchronised register: a write only
    // reaches the UART core after `reg_update` is pulsed. Mirror esp-idf's
    // `uart_ll_rxfifo_rst` (set, update, clear, update); without the updates
    // the reset never happens and the FIFO keeps accumulating.
    regs.conf0().modify(|_, w| w.rxfifo_rst().set_bit());
    uart1_reg_update();
    regs.conf0().modify(|_, w| w.rxfifo_rst().clear_bit());
    uart1_reg_update();
}

#[inline(always)]
fn uart1_reg_update() {
    // SAFETY: same UART1 ownership invariant as `uart1_rx_fifo_count`;
    // `reg_update` only commits the pending synchronised writes.
    let regs = unsafe { &*esp_hal::peripherals::UART1::ptr() };
    regs.reg_update().modify(|_, w| w.reg_update().set_bit());
    while regs.reg_update().read().reg_update().bit_is_set() {
        core::hint::spin_loop();
    }
}

#[inline(always)]
pub(crate) fn open_window_from_isr() {
    uart1_reset_rx_fifo();
}

// Each slot has its own generation counter. An odd generation means that the
// ISR is updating the slot; an even generation means that it is stable. The
// task reads the generation both before and after the payload and accepts the
// snapshot only when both reads return the same even value. The global write
// counter publishes availability, while the per-slot generation prevents a
// slow consumer from combining fields from two different ring revolutions.
// The generation cannot tell which revolution a stable slot belongs to: the
// position stored with the payload does.
#[inline(always)]
pub(crate) fn close_window_from_isr(packet_sequence: PacketSequence, channel: RailcomChannel) {
    let write_count = CAPTURE_WRITE_COUNT.load(Ordering::Relaxed);
    let slot = write_count as usize % CAPTURE_RING_CAPACITY;
    let Some(fifo_len) = uart1_rx_fifo_count().map(|len| len as usize) else {
        return;
    };
    let updating_generation = CAPTURE_GENERATIONS[slot]
        .load(Ordering::Relaxed)
        .wrapping_add(1)
        | 1;
    CAPTURE_GENERATIONS[slot].store(updating_generation, Ordering::SeqCst);
    CAPTURE_POSITIONS[slot].store(write_count, Ordering::Relaxed);
    CAPTURE_SEQUENCES[slot].store(packet_sequence.value(), Ordering::Relaxed);
    CAPTURE_CHANNELS[slot].store(u8::from(channel), Ordering::Relaxed);
    CAPTURE_LENS[slot].store(fifo_len.min(u8::MAX as usize) as u8, Ordering::Relaxed);
    for cell in &CAPTURE_BYTES[slot][..fifo_len.min(MAX_RAILCOM_WINDOW_BYTES)] {
        let Some(byte) = uart1_read_byte() else {
            break;
        };
        cell.store(byte, Ordering::Relaxed);
    }
    CAPTURE_GENERATIONS[slot].store(updating_generation.wrapping_add(1), Ordering::SeqCst);

    CAPTURE_WRITE_COUNT.store(write_count.wrapping_add(1), Ordering::Release);
    let _ = CAPTURE_NOTIFY.sender().try_send(0);
}

// See `track_output::drain_cutout_runtime_events` for the sibling ring-drain.
// Both use the same publication rule, but their payloads and overflow counters
// remain deliberately local to their hardware paths.
fn take_captured_window(next_read: &mut u32) -> Option<CapturedWindow> {
    let write = CAPTURE_WRITE_COUNT.load(Ordering::Acquire);
    let available = write.wrapping_sub(*next_read);
    if available > CAPTURE_RING_CAPACITY as u32 {
        let dropped = available - CAPTURE_RING_CAPACITY as u32;
        record_rx_overflows(dropped);
        *next_read = write.wrapping_sub(CAPTURE_RING_CAPACITY as u32);
    }

    let mut remaining = write
        .wrapping_sub(*next_read)
        .min(CAPTURE_RING_CAPACITY as u32);
    while remaining > 0 {
        let slot = *next_read as usize % CAPTURE_RING_CAPACITY;
        let generation_before = CAPTURE_GENERATIONS[slot].load(Ordering::SeqCst);
        if generation_before & 1 != 0 {
            record_rx_overflows(1);
            *next_read = next_read.wrapping_add(1);
            remaining -= 1;
            continue;
        }
        let Ok(channel) = RailcomChannel::try_from(CAPTURE_CHANNELS[slot].load(Ordering::Acquire))
        else {
            *next_read = next_read.wrapping_add(1);
            remaining -= 1;
            continue;
        };
        let len = CAPTURE_LENS[slot].load(Ordering::Acquire) as usize;
        let mut bytes = [0u8; MAX_RAILCOM_WINDOW_BYTES];
        for index in 0..len.min(MAX_RAILCOM_WINDOW_BYTES) {
            bytes[index] = CAPTURE_BYTES[slot][index].load(Ordering::Acquire);
        }
        let packet_sequence = PacketSequence::new(CAPTURE_SEQUENCES[slot].load(Ordering::Acquire));
        let position = CAPTURE_POSITIONS[slot].load(Ordering::Acquire);
        let generation_after = CAPTURE_GENERATIONS[slot].load(Ordering::SeqCst);

        // A later position means the ISR lapped this reader after it loaded
        // the write count: the window it wanted is gone, and the one in the
        // slot is delivered when the reader reaches its own position.
        if generation_before == generation_after
            && generation_after & 1 == 0
            && position == *next_read
        {
            *next_read = next_read.wrapping_add(1);
            return Some(CapturedWindow {
                packet_sequence,
                channel,
                len,
                bytes,
            });
        }
        record_rx_overflows(1);
        *next_read = next_read.wrapping_add(1);
        remaining -= 1;
    }
    None
}

#[cfg(feature = "bench-diag")]
static RAW_DUMP_COUNT: AtomicU32 = AtomicU32::new(0);

/// Bench diagnostic: log the raw bytes of the first windows after boot and
/// then one window every 100, so the byte layout per channel can be checked
/// against the scope without flooding the log.
///
/// Compiled out unless `bench-diag` is enabled: this runs once per captured
/// window, and a defmt line holds a critical section for its whole duration.
#[cfg_attr(
    not(feature = "bench-diag"),
    expect(
        unused_variables,
        reason = "the diagnostic macro removes its arguments when bench diagnostics are disabled"
    )
)]
fn log_raw_window(window: &CapturedWindow) {
    bench_diag! {
        let count = RAW_DUMP_COUNT.fetch_add(1, Ordering::Relaxed);
        if count < 60 || count.is_multiple_of(100) {
            defmt::info!(
                "railcom raw seq={} ch={} len={} bytes={=[u8]:#04x}",
                window.packet_sequence.value(),
                u8::from(window.channel),
                window.len,
                &window.bytes[..window.len.min(MAX_RAILCOM_WINDOW_BYTES)]
            );
        }
    }
}

async fn send_captured_window(sender: &RailcomRxOutputSender, window: CapturedWindow) {
    log_raw_window(&window);
    if window.len > MAX_RAILCOM_WINDOW_BYTES {
        record_rx_overflows(1);
        record_oversized_window();
        sender
            .send(RailcomRxOutput::WindowError(
                RailcomUartWindowError::WindowTooLong {
                    packet_sequence: window.packet_sequence,
                    channel: window.channel,
                    provided_len: window.len,
                    max_len: MAX_RAILCOM_WINDOW_BYTES,
                },
            ))
            .await;
        return;
    }

    match RailcomRxWindow::try_new(
        window.packet_sequence,
        window.channel,
        &window.bytes[..window.len.min(MAX_RAILCOM_WINDOW_BYTES)],
    ) {
        Ok(rx_window) => {
            sender
                .send(RailcomRxOutput::WindowProcessed(process_rx_window(
                    rx_window,
                )))
                .await;
        }
        Err(RailcomRxWindowError::WindowTooLong {
            provided_len,
            max_len,
        }) => {
            sender
                .send(RailcomRxOutput::WindowError(
                    RailcomUartWindowError::WindowTooLong {
                        packet_sequence: window.packet_sequence,
                        channel: window.channel,
                        provided_len,
                        max_len,
                    },
                ))
                .await;
        }
    }
}

fn capture_notify_receiver() -> Receiver<'static, CriticalSectionRawMutex, u8, 1> {
    CAPTURE_NOTIFY.receiver()
}

pub(crate) async fn railcom_isr_capture_task(
    uart_rx: UartRx<'static, Async>,
    result_sender: RailcomRxOutputSender,
) -> ! {
    let _uart_owner = RailcomIsrCaptureUart::new(uart_rx);
    let capture_receiver = capture_notify_receiver();
    let mut next_read = 0u32;

    loop {
        capture_receiver.receive().await;

        while let Some(window) = take_captured_window(&mut next_read) {
            send_captured_window(&result_sender, window).await;
        }
    }
}

/// Raw UART1/GPIO5 register snapshot for bench diagnostics.
///
/// Read-only: touches no control bit, so it is safe to call from a task while
/// the cutout ISR owns the FIFO data path.
#[derive(Debug, Clone, Copy, defmt::Format)]
#[cfg_attr(
    not(feature = "bench-diag"),
    expect(
        dead_code,
        reason = "constructed only by the optional bench diagnostics task"
    )
)]
pub(crate) struct Uart1RawDiag {
    pub rxfifo_cnt: u16,
    pub rxd_level: bool,
    pub rxd_edge_cnt: u16,
    pub int_raw: u32,
    pub st_urx_out: u8,
    pub conf0_rxfifo_rst: bool,
    pub u1rxd_in_sel: u8,
    pub gpio5_high_samples: u32,
    pub uart_rxd_high_samples: u32,
    pub samples: u32,
}

#[cfg_attr(
    not(feature = "bench-diag"),
    expect(
        dead_code,
        reason = "called only by the optional bench diagnostics task"
    )
)]
#[must_use]
pub(crate) fn uart1_raw_diag() -> Uart1RawDiag {
    // SAFETY: read-only register access; see the ownership note on
    // `uart1_rx_fifo_count`. The GPIO `in` register is a pure status read.
    let regs = unsafe { &*esp_hal::peripherals::UART1::ptr() };
    // SAFETY: as above, the GPIO `in` register is only read.
    let gpio = unsafe { &*esp_hal::peripherals::GPIO::ptr() };
    const SAMPLES: u32 = 40_000;
    let mut gpio5_high_samples = 0u32;
    let mut uart_rxd_high_samples = 0u32;
    for _ in 0..SAMPLES {
        if gpio.in_().read().data_next().bits() & (1 << 5) != 0 {
            gpio5_high_samples += 1;
        }
        if regs.status().read().rxd().bit_is_set() {
            uart_rxd_high_samples += 1;
        }
    }
    let status = regs.status().read();
    Uart1RawDiag {
        rxfifo_cnt: u16::from(status.rxfifo_cnt().bits()),
        rxd_level: status.rxd().bit_is_set(),
        rxd_edge_cnt: regs.rxd_cnt().read().rxd_edge_cnt().bits(),
        int_raw: regs.int_raw().read().bits(),
        st_urx_out: regs.fsm_status().read().st_urx_out().bits(),
        conf0_rxfifo_rst: regs.conf0().read().rxfifo_rst().bit_is_set(),
        u1rxd_in_sel: gpio.func_in_sel_cfg(U1RXD_SIGNAL).read().in_sel().bits(),
        gpio5_high_samples,
        uart_rxd_high_samples,
        samples: SAMPLES,
    }
}
