cc90202/DCC-esp32/src/railcom/pipeline.rs

use core::fmt;
use core::sync::atomic::Ordering;

use heapless::Vec;

use crate::diagnostics::diagnostic_counters;

use crate::cutout::{PacketSequence, RailcomChannel};

use crate::railcom::parser::{
    ParseError, RailcomParseResult, RailcomParseStatus, parse_channel1, parse_channel2,
};
use crate::railcom_data::{RailcomDatagram, RailcomItem};

diagnostic_counters! {
    static RAILCOM_RX: RailcomRxCounters;

    /// Snapshot of RX pipeline counters.
    ///
    /// Read by the host tests and by the bench dump; the counters themselves
    /// are maintained in every build.
    ///
    /// The persisted atomics cover only orthogonal outcomes; `rx_window_count`
    /// and `rx_windows_with_bytes_count` are derived at snapshot time so the
    /// totals stay exactly consistent with their parts regardless of ISR racing.
    #[cfg(any(test, feature = "bench-diag"))]
    pub snapshot RailcomRxStats;

    @test reset;

    // Per-outcome counters. Every window lands in exactly one bucket.
    rx_empty_window_count,
    rx_parse_ok_count,
    rx_parse_err_count,
    rx_oversized_window_count,
    // Within-parsed counters (not mutually exclusive; derived from items).
    rx_ack_count,
    rx_nack_count,
    rx_busy_count,
    rx_adr_high_count,
    rx_adr_low_count,
    // Capture-level overflow counter (dropped ring entries or oversized windows).
    rx_overflow_count,
    // Delivery between the dispatcher and the single-flight POM actor.
    pom_result_forwarded_count,
    pom_result_dropped_count,
}

/// Number of RailCom receive channels tracked by per-channel diagnostics.
pub const RAILCOM_CHANNEL_COUNT: usize = 2;

diagnostic_counters! {
    static RX_CHANNEL: [RailcomChannelCounters; RAILCOM_CHANNEL_COUNT];

    /// Snapshot of one RailCom receive channel's counters.
    ///
    /// Read by the bench dump only.
    #[cfg(any(test, feature = "bench-diag"))]
    pub snapshot RailcomChannelStats;

    @test reset;

    window_count,
    empty_count,
}

pub(crate) const MAX_RAILCOM_WINDOW_BYTES: usize = 6;

#[derive(Debug, Clone, Copy, PartialEq, Eq)]
#[cfg_attr(target_arch = "riscv32", derive(defmt::Format))]
pub enum RailcomRxWindowError {
    WindowTooLong { provided_len: usize, max_len: usize },
}

impl fmt::Display for RailcomRxWindowError {
    fn fmt(&self, formatter: &mut fmt::Formatter<'_>) -> fmt::Result {
        match self {
            Self::WindowTooLong {
                provided_len,
                max_len,
            } => write!(
                formatter,
                "RailCom window has {provided_len} bytes; maximum is {max_len}"
            ),
        }
    }
}

impl core::error::Error for RailcomRxWindowError {}

/// One logical RailCom receive window.
///
/// At most 6 raw bytes: the largest supported CH2 datagram spans 6 encoded
/// 4/8 symbols.
#[derive(Debug, Clone, Copy, PartialEq, Eq)]
#[cfg_attr(target_arch = "riscv32", derive(defmt::Format))]
pub struct RailcomRxWindow {
    pub packet_sequence: PacketSequence,
    pub channel: RailcomChannel,
    raw_len: u8,
    raw_bytes: [u8; 6],
}

impl RailcomRxWindow {
    pub fn try_new(
        packet_sequence: impl Into<PacketSequence>,
        channel: RailcomChannel,
        raw_bytes: &[u8],
    ) -> Result<Self, RailcomRxWindowError> {
        if raw_bytes.len() > MAX_RAILCOM_WINDOW_BYTES {
            return Err(RailcomRxWindowError::WindowTooLong {
                provided_len: raw_bytes.len(),
                max_len: MAX_RAILCOM_WINDOW_BYTES,
            });
        }

        let mut stored = [0u8; MAX_RAILCOM_WINDOW_BYTES];
        let len = raw_bytes.len();
        stored[..len].copy_from_slice(raw_bytes);

        Ok(Self {
            packet_sequence: packet_sequence.into(),
            channel,
            raw_len: len as u8,
            raw_bytes: stored,
        })
    }

    #[must_use]
    pub fn raw_slice(&self) -> &[u8] {
        &self.raw_bytes[..self.raw_len as usize]
    }

    #[must_use]
    pub const fn raw_len(&self) -> usize {
        self.raw_len as usize
    }

    #[must_use]
    pub const fn is_empty(&self) -> bool {
        self.raw_len == 0
    }
}

#[derive(Debug, Clone, Copy, PartialEq, Eq)]
#[cfg_attr(target_arch = "riscv32", derive(defmt::Format))]
pub enum RailcomRxOutcome {
    Empty,
    Parsed,
    ParseError(ParseError),
    PartialUnsupportedDatagram(u8),
}

#[derive(Debug, Clone, PartialEq, Eq)]
#[cfg_attr(target_arch = "riscv32", derive(defmt::Format))]
pub struct RailcomRxResult {
    pub window: RailcomRxWindow,
    pub outcome: RailcomRxOutcome,
    pub items: Vec<RailcomItem, 6>,
}

impl RailcomRxResult {
    /// Returns items that are safe to use for state changes and POM results.
    ///
    /// A partial parse keeps its valid prefix for diagnostics, but that prefix
    /// must not identify a locomotive or acknowledge a command.
    #[must_use]
    pub fn complete_items(&self) -> &[RailcomItem] {
        if matches!(self.outcome, RailcomRxOutcome::Parsed) {
            self.items.as_slice()
        } else {
            &[]
        }
    }
}

#[cfg(any(test, feature = "bench-diag"))]
impl RailcomRxStats {
    #[must_use]
    pub fn rx_windows_with_bytes_count(&self) -> u32 {
        self.rx_parse_ok_count + self.rx_parse_err_count + self.rx_oversized_window_count
    }

    #[must_use]
    pub fn rx_window_count(&self) -> u32 {
        self.rx_empty_window_count + self.rx_windows_with_bytes_count()
    }
}

#[must_use]
#[cfg(any(test, feature = "bench-diag"))]
pub fn railcom_rx_stats() -> RailcomRxStats {
    RAILCOM_RX.snapshot()
}

/// Per-channel receive counters, ordered as channel 1 followed by channel 2.
#[must_use]
#[cfg(any(test, feature = "bench-diag"))]
pub fn railcom_rx_channel_stats() -> [RailcomChannelStats; RAILCOM_CHANNEL_COUNT] {
    core::array::from_fn(|index| RX_CHANNEL[index].snapshot())
}

#[cfg(test)]
pub fn reset_railcom_rx_stats() {
    RAILCOM_RX.reset();
    for channel in &RX_CHANNEL {
        channel.reset();
    }
}

pub fn record_oversized_window() {
    RAILCOM_RX
        .rx_oversized_window_count
        .fetch_add(1, Ordering::Relaxed);
}

pub fn record_rx_overflows(count: u32) {
    RAILCOM_RX
        .rx_overflow_count
        .fetch_add(count, Ordering::Relaxed);
}

#[cfg(any(target_arch = "riscv32", test))]
pub(crate) fn record_pom_result_forwarded() {
    RAILCOM_RX
        .pom_result_forwarded_count
        .fetch_add(1, Ordering::Relaxed);
}

#[cfg(any(target_arch = "riscv32", test))]
pub(crate) fn record_pom_result_dropped() {
    RAILCOM_RX
        .pom_result_dropped_count
        .fetch_add(1, Ordering::Relaxed);
}

fn record_channel_window(channel: RailcomChannel) {
    RX_CHANNEL[channel.index()]
        .window_count
        .fetch_add(1, Ordering::Relaxed);
}

fn record_channel_empty(channel: RailcomChannel) {
    RX_CHANNEL[channel.index()]
        .empty_count
        .fetch_add(1, Ordering::Relaxed);
}

fn parsed_result(window: RailcomRxWindow, parsed: RailcomParseResult) -> RailcomRxResult {
    RAILCOM_RX.rx_parse_ok_count.fetch_add(1, Ordering::Relaxed);
    record_parsed_items(parsed.items.as_slice());

    RailcomRxResult {
        window,
        outcome: match parsed.status {
            RailcomParseStatus::Complete => RailcomRxOutcome::Parsed,
            RailcomParseStatus::PartialUnsupportedDatagram(id) => {
                RailcomRxOutcome::PartialUnsupportedDatagram(id)
            }
        },
        items: parsed.items,
    }
}

#[must_use]
pub fn process_rx_window(window: RailcomRxWindow) -> RailcomRxResult {
    record_channel_window(window.channel);
    if window.is_empty() {
        RAILCOM_RX
            .rx_empty_window_count
            .fetch_add(1, Ordering::Relaxed);
        record_channel_empty(window.channel);
        return RailcomRxResult {
            window,
            outcome: RailcomRxOutcome::Empty,
            items: Vec::new(),
        };
    }

    let parse_fn = match window.channel {
        RailcomChannel::Channel1 => parse_channel1,
        RailcomChannel::Channel2 => parse_channel2,
    };

    match parse_fn(window.raw_slice()) {
        Ok(parsed) => parsed_result(window, parsed),
        Err(err) => {
            RAILCOM_RX
                .rx_parse_err_count
                .fetch_add(1, Ordering::Relaxed);
            RailcomRxResult {
                window,
                outcome: RailcomRxOutcome::ParseError(err),
                items: Vec::new(),
            }
        }
    }
}

fn record_parsed_items(items: &[RailcomItem]) {
    for item in items {
        match item {
            RailcomItem::Ack => {
                RAILCOM_RX.rx_ack_count.fetch_add(1, Ordering::Relaxed);
            }
            RailcomItem::Nack => {
                RAILCOM_RX.rx_nack_count.fetch_add(1, Ordering::Relaxed);
            }
            RailcomItem::Busy => {
                RAILCOM_RX.rx_busy_count.fetch_add(1, Ordering::Relaxed);
            }
            RailcomItem::Datagram(RailcomDatagram::AdrHigh(_)) => {
                RAILCOM_RX.rx_adr_high_count.fetch_add(1, Ordering::Relaxed);
            }
            RailcomItem::Datagram(RailcomDatagram::AdrLow(_)) => {
                RAILCOM_RX.rx_adr_low_count.fetch_add(1, Ordering::Relaxed);
            }
            RailcomItem::Datagram(
                RailcomDatagram::CvData(_)
                | RailcomDatagram::Ext(_)
                | RailcomDatagram::Info1(_)
                | RailcomDatagram::Dyn { .. }
                | RailcomDatagram::Xpom { .. }
                | RailcomDatagram::Search(_),
            ) => {}
        }
    }
}

#[cfg(test)]
mod tests {
    use super::*;
    use crate::railcom::RailcomDatagram;
    use crate::railcom::parser::{ACK_1_CODE, ACK_2_CODE, BUSY_CODE};
    use std::sync::Mutex;

    const TEST_ID0_CODE_0X42: [u8; 2] = [0b1010_1010, 0b1010_1001];
    static RAILCOM_RX_STATS_TEST_LOCK: Mutex<()> = Mutex::new(());

    #[test]
    fn test_process_rx_window_empty_window() {
        let _guard = RAILCOM_RX_STATS_TEST_LOCK
            .lock()
            .expect("test lock poisoned");
        reset_railcom_rx_stats();
        let window = RailcomRxWindow::try_new(7, RailcomChannel::Channel2, &[])
            .expect("empty window must fit");
        let result = process_rx_window(window);

        assert_eq!(result.outcome, RailcomRxOutcome::Empty);
        assert!(result.items.is_empty());
        let stats = railcom_rx_stats();
        assert_eq!(stats.rx_window_count(), 1);
        assert_eq!(stats.rx_empty_window_count, 1);
        assert_eq!(stats.rx_windows_with_bytes_count(), 0);
    }

    #[test]
    fn test_process_rx_window_channel2_parsed() {
        let _guard = RAILCOM_RX_STATS_TEST_LOCK
            .lock()
            .expect("test lock poisoned");
        reset_railcom_rx_stats();
        let raw = [TEST_ID0_CODE_0X42[0], TEST_ID0_CODE_0X42[1], ACK_1_CODE];
        let window = RailcomRxWindow::try_new(11, RailcomChannel::Channel2, &raw)
            .expect("raw window must fit");
        let result = process_rx_window(window);

        assert_eq!(result.outcome, RailcomRxOutcome::Parsed);
        assert_eq!(
            result.items.as_slice(),
            &[
                RailcomItem::Datagram(RailcomDatagram::CvData(0x42)),
                RailcomItem::Ack,
            ]
        );
        assert_eq!(result.complete_items(), result.items.as_slice());
        let stats = railcom_rx_stats();
        assert_eq!(stats.rx_window_count(), 1);
        assert_eq!(stats.rx_windows_with_bytes_count(), 1);
        assert_eq!(stats.rx_parse_ok_count, 1);
        assert_eq!(stats.rx_ack_count, 1);
    }

    #[test]
    fn test_process_rx_window_counts_a_busy_reply() {
        let _guard = RAILCOM_RX_STATS_TEST_LOCK
            .lock()
            .expect("test lock poisoned");
        reset_railcom_rx_stats();
        let raw = [TEST_ID0_CODE_0X42[0], TEST_ID0_CODE_0X42[1], BUSY_CODE];
        let window = RailcomRxWindow::try_new(12, RailcomChannel::Channel2, &raw)
            .expect("raw window must fit");
        let result = process_rx_window(window);

        assert_eq!(result.outcome, RailcomRxOutcome::Parsed);
        assert_eq!(
            result.items.as_slice(),
            &[
                RailcomItem::Datagram(RailcomDatagram::CvData(0x42)),
                RailcomItem::Busy,
            ]
        );
        let stats = railcom_rx_stats();
        assert_eq!(stats.rx_parse_ok_count, 1);
        assert_eq!(stats.rx_busy_count, 1);
        assert_eq!(stats.rx_ack_count, 0);
        assert_eq!(stats.rx_nack_count, 0);
    }

    #[test]
    fn test_process_rx_window_hides_a_verdict_cut_short_before_a_busy() {
        // The guard that makes the busy rule hold. A window truncated at an
        // unsupported identifier keeps its prefix for diagnostics, and that
        // prefix can end in an ACK while the BUSY that would have cancelled it
        // sits past the cut. Only `complete_items` keeps such a prefix away
        // from the POM path; without it the ACK would speak for a decoder that
        // went on to say it could not answer.
        let _guard = RAILCOM_RX_STATS_TEST_LOCK
            .lock()
            .expect("test lock poisoned");
        reset_railcom_rx_stats();
        let raw = [
            TEST_ID0_CODE_0X42[0],
            TEST_ID0_CODE_0X42[1],
            ACK_1_CODE,
            0b0110_0110, // identifier 6, which nothing decodes
            BUSY_CODE,
        ];
        let window = RailcomRxWindow::try_new(14, RailcomChannel::Channel2, &raw)
            .expect("raw window must fit");
        let result = process_rx_window(window);

        assert_eq!(
            result.items.as_slice(),
            &[
                RailcomItem::Datagram(RailcomDatagram::CvData(0x42)),
                RailcomItem::Ack,
            ]
        );
        assert!(result.complete_items().is_empty());
    }

    #[test]
    fn test_process_rx_window_does_not_count_a_rejected_channel1_busy() {
        // Channel 1 forbids control symbols, so the window is an error and the
        // busy counter must stay put: it counts replies, not rejected bytes.
        let _guard = RAILCOM_RX_STATS_TEST_LOCK
            .lock()
            .expect("test lock poisoned");
        reset_railcom_rx_stats();
        let window = RailcomRxWindow::try_new(13, RailcomChannel::Channel1, &[BUSY_CODE])
            .expect("raw window must fit");
        let result = process_rx_window(window);

        assert_ne!(result.outcome, RailcomRxOutcome::Parsed);
        let stats = railcom_rx_stats();
        assert_eq!(stats.rx_busy_count, 0);
        assert_eq!(stats.rx_parse_err_count, 1);
    }

    #[test]
    fn test_process_rx_window_partial_unsupported_datagram_keeps_prefix() {
        let _guard = RAILCOM_RX_STATS_TEST_LOCK
            .lock()
            .expect("test lock poisoned");
        reset_railcom_rx_stats();
        let raw = [
            TEST_ID0_CODE_0X42[0],
            TEST_ID0_CODE_0X42[1],
            0b1011_0010,
            0b1010_1100,
        ];
        let window = RailcomRxWindow::try_new(21, RailcomChannel::Channel2, &raw)
            .expect("raw window must fit");
        let result = process_rx_window(window);

        assert_eq!(
            result.outcome,
            RailcomRxOutcome::PartialUnsupportedDatagram(4)
        );
        assert_eq!(
            result.items.as_slice(),
            &[RailcomItem::Datagram(RailcomDatagram::CvData(0x42))]
        );
        assert!(result.complete_items().is_empty());
        assert_eq!(railcom_rx_stats().rx_parse_ok_count, 1);
        assert_eq!(railcom_rx_stats().rx_parse_err_count, 0);
    }

    #[test]
    fn test_pom_delivery_counters_are_independent() {
        let _guard = RAILCOM_RX_STATS_TEST_LOCK
            .lock()
            .expect("test lock poisoned");
        reset_railcom_rx_stats();

        record_pom_result_forwarded();
        record_pom_result_forwarded();
        record_pom_result_dropped();

        let stats = railcom_rx_stats();
        assert_eq!(stats.pom_result_forwarded_count, 2);
        assert_eq!(stats.pom_result_dropped_count, 1);
        assert_eq!(stats.rx_window_count(), 0);
    }

    #[test]
    fn test_process_rx_window_channel2_parse_error() {
        let _guard = RAILCOM_RX_STATS_TEST_LOCK
            .lock()
            .expect("test lock poisoned");
        reset_railcom_rx_stats();
        let window = RailcomRxWindow::try_new(15, RailcomChannel::Channel2, &[0xff])
            .expect("single-byte window must fit");
        let result = process_rx_window(window);

        assert_eq!(
            result.outcome,
            RailcomRxOutcome::ParseError(ParseError::Invalid4Of8Code(0xff))
        );
        assert!(result.items.is_empty());
        assert_eq!(railcom_rx_stats().rx_parse_err_count, 1);
    }

    #[test]
    fn test_try_new_rejects_too_long_window() {
        let err = RailcomRxWindow::try_new(23, RailcomChannel::Channel2, &[0, 1, 2, 3, 4, 5, 6])
            .expect_err("window longer than 6 bytes must be rejected");

        assert_eq!(
            err,
            RailcomRxWindowError::WindowTooLong {
                provided_len: 7,
                max_len: 6,
            }
        );
    }

    #[test]
    fn test_process_rx_window_channel1_parses_address_datagram() {
        let _guard = RAILCOM_RX_STATS_TEST_LOCK
            .lock()
            .expect("test lock poisoned");
        reset_railcom_rx_stats();
        let raw = [0b1001_1001, 0b1100_1001];
        let window = RailcomRxWindow::try_new(19, RailcomChannel::Channel1, &raw)
            .expect("CH1 address window must fit");
        let result = process_rx_window(window);

        assert_eq!(result.outcome, RailcomRxOutcome::Parsed);
        assert_eq!(
            result.items.as_slice(),
            &[RailcomItem::Datagram(RailcomDatagram::AdrLow(42))]
        );
        let stats = railcom_rx_stats();
        assert_eq!(stats.rx_windows_with_bytes_count(), 1);
        assert_eq!(stats.rx_parse_ok_count, 1);
        assert_eq!(stats.rx_parse_err_count, 0);
        let channels = railcom_rx_channel_stats();
        assert_eq!(channels[RailcomChannel::Channel1.index()].window_count, 1);
        assert_eq!(stats.rx_adr_low_count, 1);
    }

    #[test]
    fn test_invalid_channel1_does_not_discard_valid_channel2() {
        let _guard = RAILCOM_RX_STATS_TEST_LOCK
            .lock()
            .expect("test lock poisoned");
        reset_railcom_rx_stats();
        let window = RailcomRxWindow::try_new(19, RailcomChannel::Channel1, &[ACK_2_CODE])
            .expect("single-byte CH1 window must fit");
        let result = process_rx_window(window);

        assert_eq!(
            result.outcome,
            RailcomRxOutcome::ParseError(ParseError::ControlSymbolNotAllowed(ACK_2_CODE))
        );
        assert!(result.complete_items().is_empty());
        let stats = railcom_rx_stats();
        assert_eq!(stats.rx_parse_ok_count, 0);
        assert_eq!(stats.rx_parse_err_count, 1);
        let channels = railcom_rx_channel_stats();
        assert_eq!(channels[RailcomChannel::Channel1.index()].window_count, 1);
        assert_eq!(stats.rx_ack_count, 0);
        let ch2 = process_rx_window(
            RailcomRxWindow::try_new(19, RailcomChannel::Channel2, &TEST_ID0_CODE_0X42).unwrap(),
        );
        assert_eq!(ch2.outcome, RailcomRxOutcome::Parsed);
        assert_eq!(
            ch2.complete_items(),
            &[RailcomItem::Datagram(RailcomDatagram::CvData(0x42))]
        );
    }

    #[test]
    fn test_packet_sequence_age_since_wraps() {
        let earlier = PacketSequence::new(u32::MAX - 1);
        let later = PacketSequence::new(1);

        assert_eq!(later.age_since(earlier), 3);
    }

    #[test]
    fn test_packet_sequence_is_within_inclusive_window() {
        let earlier = PacketSequence::new(10);

        assert!(PacketSequence::new(18).is_within(earlier, 8));
        assert!(!PacketSequence::new(19).is_within(earlier, 8));
    }

    #[test]
    fn test_record_oversized_window_updates_aggregate_stats() {
        let _guard = RAILCOM_RX_STATS_TEST_LOCK
            .lock()
            .expect("test lock poisoned");
        reset_railcom_rx_stats();
        record_oversized_window();

        let stats = railcom_rx_stats();
        assert_eq!(stats.rx_window_count(), 1);
        assert_eq!(stats.rx_windows_with_bytes_count(), 1);
        assert_eq!(stats.rx_oversized_window_count, 1);
    }
}
