cc90202/DCC-esp32/src/short_detector.rs

//! Track short-circuit detector using an active-low GPIO signal.
//!
//! GPIO3 is wired to the FAULT pin of the DRV8874 carrier. That pin is open
//! drain and can only pull down, so the line is held up by the pull-up inside
//! the ESP32-C6, enabled here.
//!
//! - Normal operation: GPIO3 = HIGH (3.3V)
//! - Short circuit:    GPIO3 = LOW  (0V)  → falling edge triggers fault
//!
//! Monitors GPIO3 for track short-circuit detection.
//! The signal is active-low: GPIO3=LOW means short detected. A falling-edge interrupt opens a
//! qualification window: the pin is sampled every millisecond and the fault latches only when
//! the line stays LOW for most of the window (75 of 100 samples), the tolerance DCC-EX gives its
//! fault pin. Motor inrush, the charging of a decoder's keep-alive capacitor and wheel
//! micro-shorts on turnouts end sooner and are ignored; the DRV8874's
//! hardware current limit protects the output during qualification. A confirmed short emits
//! `FaultEvent::FaultLatched(TrackShort)` to the fault manager.
//!
//! For the first 5 seconds after power-up the task blanks the input entirely:
//! the power-up transient trips the detector often enough that acting on it
//! would be useless. After that, falling edges are qualified as described
//! above, and a confirmed short disables the track output through GPIO18 before
//! the fault event is even sent, which takes about 100 ms in the worst case.
//!
//! When the short clears and GPIO3 goes HIGH again, the fault stays latched.
//! Recovery is deliberately manual, through the long-resume button or a service
//! action, because auto-recovery on a persistent short turns into an on/off
//! cycle that stresses the driver.

#[cfg(any(test, target_arch = "riscv32"))]
mod qualifier;

#[cfg(target_arch = "riscv32")]
use crate::station_status::FaultManagerState;
#[cfg(target_arch = "riscv32")]
use crate::system_status::channels::{BootReadySender, FaultEventSender, FaultStateReceiver};
#[cfg(target_arch = "riscv32")]
use crate::system_status::{BootReadyEvent, announce_ready};
#[cfg(target_arch = "riscv32")]
use core::cell::Cell;
#[cfg(target_arch = "riscv32")]
use embassy_futures::select::{Either, select};
#[cfg(target_arch = "riscv32")]
use embassy_time::{Duration, Timer};
#[cfg(target_arch = "riscv32")]
use esp_hal::gpio::{Input, InputConfig, Pull};
#[cfg(target_arch = "riscv32")]
use qualifier::{ShortQualifier, ShortSuppression};

#[cfg(target_arch = "riscv32")]
const TRACK_SHORT_BOOT_BLANKING_MS: u64 = 5_000;

/// Settling delay after the fault manager re-enters Normal, before re-arming
/// short detection. Lets the track driver wake up and the decoder's bulk/keep-alive
/// capacitor charge through the rails without a transient OCP pulse on FAULT
/// being interpreted as a persistent short.
#[cfg(target_arch = "riscv32")]
const RECOVERY_SETTLE_MS: u64 = 100;

#[cfg(target_arch = "riscv32")]
static SHORT_SUPPRESSION: critical_section::Mutex<Cell<ShortSuppression>> =
    critical_section::Mutex::new(Cell::new(ShortSuppression { until_ms: 0 }));

#[cfg(target_arch = "riscv32")]
pub(crate) fn suppress_short_edges_for(duration: Duration) {
    critical_section::with(|cs| {
        SHORT_SUPPRESSION
            .borrow(cs)
            .set(ShortSuppression::starting_at(
                crate::clock::now_ms(),
                duration.as_millis(),
            ));
    });
}

/// Gives the first power-on after boot the same settling time as a resume.
///
/// Arming the track at boot keeps the fault manager in Normal, so the settle
/// that follows every return to Normal never runs; keep-alive capacitors on
/// the track would then be qualified from the first millisecond.
#[cfg(target_arch = "riscv32")]
pub(crate) fn settle_after_arming() {
    suppress_short_edges_for(Duration::from_millis(RECOVERY_SETTLE_MS));
}

#[cfg(target_arch = "riscv32")]
fn short_edges_suppressed() -> bool {
    critical_section::with(|cs| {
        SHORT_SUPPRESSION
            .borrow(cs)
            .get()
            .is_active_at(crate::clock::now_ms())
    })
}

/// Interval between pin samples during short qualification.
#[cfg(target_arch = "riscv32")]
const SHORT_CONFIRM_SAMPLE_INTERVAL_MS: u64 = 1;

/// Build the GPIO3 input pin for short-circuit detection (active-low, pull-up).
#[cfg(target_arch = "riscv32")]
#[must_use]
pub(crate) fn new_short_detect_input(
    gpio3: esp_hal::peripherals::GPIO3<'static>,
) -> Input<'static> {
    let config = InputConfig::default().with_pull(Pull::Up);
    Input::new(gpio3, config)
}

/// Sample GPIO3 every [`SHORT_CONFIRM_SAMPLE_INTERVAL_MS`] and return whether
/// the short persists long enough to be treated as real. Returns as soon as
/// the verdict is decided (worst case [`SHORT_CONFIRM_SAMPLES`](qualifier::SHORT_CONFIRM_SAMPLES) ms). During
/// qualification the DRV8874's hardware current limit keeps the output safe.
#[cfg(target_arch = "riscv32")]
async fn confirm_short(pin: &Input<'static>) -> bool {
    let mut qualifier = ShortQualifier::new();
    loop {
        if let Some(verdict) = qualifier.record(pin.is_low()) {
            return verdict;
        }
        Timer::after(Duration::from_millis(SHORT_CONFIRM_SAMPLE_INTERVAL_MS)).await;
    }
}

#[cfg(target_arch = "riscv32")]
async fn report_track_short(fault_sender: &FaultEventSender) {
    if !crate::track_output::emergency_disable() {
        defmt::error!("track short detected before output hardware initialization");
    }
    defmt::warn!("Short circuit detected on GPIO3!");
    fault_sender
        .send(crate::station_status::FaultEvent::FaultLatched(
            crate::station_status::FaultCause::TrackShort,
        ))
        .await;
}

/// Reports a confirmed short, then waits for the fault manager to publish
/// the state it moves to and returns that state.
#[cfg(target_arch = "riscv32")]
async fn report_and_wait(
    fault_sender: &FaultEventSender,
    fault_state_receiver: &mut FaultStateReceiver,
) -> FaultManagerState {
    report_track_short(fault_sender).await;
    fault_state_receiver.changed().await
}
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
