cc90202/DCC-esp32/(commit log)

2026-03-27 Initial public release - DCC command station for ESP32-C6
    [partitions.csv]
2026-03-27 style: apply cargo fmt formatting fixes
    [boot.rs, fault_manager.rs, mod.rs, packet.rs, scheduler.rs, validator.rs]
2026-03-28 fix(display): make throbber timer resilient and faster
    [display.rs]
2026-03-30 feat(engine): ISR-driven RMT transmission, zero executor blocking
    Replace Embassy-task-based RMT engine with interrupt-driven architecture
    modelled after DCC-EX on ESP32. The RMT hardware loops continuously
    (TX_CONTI_MODE) and an ISR swaps the data portion in RMT RAM at each
    packet boundary, using the preamble playback (~2.3ms) as a timing buffer.
    New module rmt_driver.rs: init, ISR (CH_TX_LOOP via InfiniteWithInterrupt),
    shared buffer with ACK-based handshake preserving scheduler backpressure.
    All unsafe blocks documented with SAFETY comments per M-UNSAFE guideline.
    engine.rs becomes a lightweight async feeder task: receive, encode, submit.
    encoder.rs gains encode_dcc_data_portion (preamb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
    [boot.rs, encoder.rs, engine.rs, mod.rs, rmt_driver.rs, timing.rs]
2026-04-02 feat(engine): ISR-driven RMT transmission, zero executor blocking
    Replace the executor-blocking DCC engine loop with an interrupt-driven
    RMT backend. The RMT peripheral now runs in continuous-loop mode and
    refills its buffer from a one-shot ISR, freeing the Embassy executor
    for other tasks. Pre-encoded idle packets are written directly to RMT
    RAM so the DCC signal never gaps.
    Key changes:
    - New rmt_driver module: ISR-based RMT transmission with loop counter
    - engine.rs simplified to async packet dispatch (no longer touches RMT)
    - encoder.rs gains encode_packet_to_rmt() for direct RMT symbol output
    - timing.rs expanded with RMT-specific constants
    - boot.rs wired for new rmt_driver::init() in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
    [boot.rs, encoder.rs, engine.rs, mod.rs, rmt_driver.rs, timing.rs]
2026-07-03 feat(railcom): add POM and runtime cutout integration
2026-07-03 docs(railcom): add public hardware and design notes
2026-07-04 feat(wifi): add persistent credential store
    [partitions.csv]
2026-07-04 feat(wifi): wire flash-backed boot credentials
2026-07-04 feat(wifi): reboot after provisioning save
    [mod.rs]
2026-07-04 fix(wifi): harden credential store updates
    [mod.rs]
2026-07-04 fix(flash): include wifi config partition
    [partitions.csv]
2026-07-23 fix: qualify short detector before latching
    [short_detector.rs]
2026-07-23 style: format short detector tests import
    [short_detector.rs]
2026-07-24 docs: update short detector docs
    [short_detector.rs]
2026-07-27 refactor(errors): retain hardware failure context
    [hardware.rs, rmt_driver.rs]
2026-07-27 test(dcc): enforce packet byte capacity
2026-07-27 refactor(railcom): split runtime dispatch responsibilities
2026-07-27 refactor(driver): centralize ISR seqlock slots
2026-07-27 refactor(errors): implement Display for network failures
    [error.rs, runtime_tasks.rs]
2026-07-27 refactor(z21): make encoder failures explicit
    [railcom.rs, tests.rs]
2026-07-27 refactor: strengthen ISR and protocol boundaries
    [isr_capture.rs, packet.rs, rmt_driver.rs, track_output.rs, uart_reader.rs]
2026-07-27 refactor: strengthen remaining domain boundaries
    [error.rs, hardware.rs, lib.rs, parser.rs, railcom.rs, scheduler.rs, short_detector.rs]
2026-07-27 docs: complete public error contracts
    [error.rs]
2026-07-27 fix: close follow-up review findings
    [main.rs, scheduler.rs, seqlock.rs, slot_manager.rs]
2026-08-25 fix: stop track power when controller times out
    [authority.rs, boot.rs, core.rs, engine.rs, error.rs, fault_manager.rs]
2026-09-02 fix(railcom): emit the cutout reference edge and hit its deadline
    RCN-217 times the cutout from the zero crossing that closes the end bit
    and opens the first preamble bit. We never emitted that transition: the
    RMT padding went low straight after the end bit, so the decoder had no
    edge to reference and stayed silent through the window. Drive the first
    preamble half for 32 us before the brake takes over the rail, and anchor
    every cutout timestamp on that edge instead of on the end of the packet.
    Cutout start moves from 26 to 28 us, mid-window.
    Arriving on time is the other half of the problem. Interrupt entry can be
    held off for tens of microseconds by the WiFi driver's critical sections,
    aga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
    [cutout.rs, rmt_driver.rs, track_output.rs]
2026-09-02 fix(railcom): re-enable the track drive before closing the window
    The RMT padding ends at the same instant the cutout does, so the next
    preamble bit is already due on the wire while the handler is still doing
    its bookkeeping. Running that work before the GPIO flip truncated the
    first half bit.
    [track_output.rs]
2026-09-02 chore(tools): take the command station address on the command line
    The board gets a new address on every reboot, so stop hardcoding it.
    Also slow the loop down: reading twice a second kept renewing the
    controller lease and locked the Z21 app out.
2026-09-08 fix(railcom): enforce RCN-217 symbol rules and report NACK on POM writes
    Reject 0xF8 as an ACK, refuse ACK/NACK in channel 1 and datagrams after
    an initial control symbol in channel 2. A write answered by ACK+NACK is
    a rejected write, not a success. Drop the UART break-tail byte that lands
    ahead of the channel-1 datagram while the detector line is still low.
    [parser.rs, pipeline.rs]
2026-09-08 fix(fault): keep short suppression and power fence correct over long uptimes
    Track the short-edge suppression deadline on the 64-bit clock so it cannot
    reappear after a counter wrap. Ignore stale power fence acks and keep
    waiting for the expected one within the 500 ms budget, with stop and fault
    events taking precedence. Cut the bridge before the RMT watchdog reports
    the stall and resets.
    [engine.rs, fault_manager.rs, short_detector.rs]
2026-09-08 fix(railcom): match the LM339 front end and reset the UART FIFO properly
    The comparator output is open-collector with a pull-up: the line idles
    high, so drop the input inverter and use the internal pull-up. Pulse
    reg_update around the rxfifo_rst toggle, otherwise the ESP32-C6 never
    applies the reset and bytes accumulate across windows.
    [hardware.rs, isr_capture.rs]
2026-09-08 chore(railcom): add bench diagnostics for the UART capture path
    Log sampled raw windows, a UART1/GPIO5 register snapshot and every
    channel-2 window of a POM cutout. Bench only, to be removed before release.
2026-09-08 docs(hardware): describe the current breadboard and update the inventory
    Add the current-circuit description after phase 3, mark the phase 3 wiring
    procedure as executed and rewrite the inventory around what is mounted,
    what is in the drawer and what left the design.
2026-09-10 fix(railcom): re-send POM read bursts and accept CV data only at the head of CH2
    Some decoders (ZIMO, seen on a Roco locomotive) acknowledge a POM read in
    the first cutout and deliver the CV value only after a later read packet,
    once the value is ready. A single burst of four packets ended before that,
    and refresh packets did not solicit the answer, so every read timed out.
    The burst is now re-sent every 150 ms until a value arrives or the 1.5 s
    response timeout expires. Writes keep a single burst.
    A CV datagram is accepted only as the first datagram of channel 2, where
    RCN-217 places it. A dynamic-data window that lost one symbol re-aligned
    into a trailing CV datagram and was reported to t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
2026-09-12 feat(diagnostics): put the bench logging behind a cargo feature
    Every defmt line is written inside a critical section, so a log statement
    on a per-packet path holds off the DCC waveform interrupt and the RailCom
    cutout timer, which are exactly the ones whose timing we measure in
    microseconds. The noisiest ones were also the least throttled: the raw
    window dump, a line for every channel-2 window of a POM read, the periodic
    counter task and a line per network command.
    They are now compiled out unless bench-diag is enabled. Boot messages,
    warnings and errors are untouched, and the counters keep being updated;
    only their output is gated.
    [boot.rs, isr_capture.rs, lib.rs, macros.rs, mod.rs]
2026-09-12 refactor(dcc): extract actors and strengthen types
    [encoder.rs, lib.rs]
2026-09-12 fix: harden safety, network, and RailCom handling
    [boot.rs, cutout.rs, engine.rs, error.rs]
2026-09-12 docs: update wiring, references, and layout
2026-09-13 docs(hardware): update bench wiring and fault investigation
2026-10-12 fix(restart): reset the Wi-Fi modem before every software reset
    After a software reset the board joined the network and got its
    address but nobody could reach it, through every later reset, until a
    power cycle. esp-hal's software_reset leaves the modem as it was;
    ESP-IDF's esp_restart on the ESP32-C6 pulses the modem resets first.
    Do the same in one helper and use it everywhere a restart is requested.
2026-10-12 feat(ota)!: add signed Wi-Fi firmware updates with rollback
    A browser page at /update takes an Ed25519-signed package, writes it to
    the inactive slot and restarts into it for a trial. The new image is
    confirmed after a healthy minute; a crash or a failed check during the
    trial goes back to the previous image and rejects that release. A
    two-sector journal keeps the update state across power cuts. The track
    stays off during the update, the trial and the first boot after it;
    the display, the LED and the status page show every step.
    The update logic lives in the dcc-ota crate; ota-pack signs and
    inspects packages on the host.
    BREAKING CHANGE: the flash layout becomes the 8 MB dual-slot table;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
2026-10-12 refactor(ota): drop the development signing key
    Every build now trusts the release key only. The ota-dev-key feature,
    the development public key and its fingerprint check are removed; the
    fault-injection build keeps its own build kind and is signed with the
    release key. Build kind value 1 is no longer valid.
2026-10-12 refactor: break the module dependency cycles
    Each channel alias now lives beside the message type it carries, the
    bench diagnostics are assembled at the composition root instead of by
    the module they read from, and the lease registry sits with the lease
    types. `runtime_channels` keeps only the parameterised forms and imports
    nothing from the crate, so it cannot take part in a cycle.
2026-10-12 ci: fail the build on warnings and broken doc links
    Both on the host and on the firmware target. Declared through
    `[lints.rust]` rather than RUSTFLAGS, which would replace the target
    rustflags carrying the linker scripts and break the firmware link
    instead of tightening a lint.
2026-10-12 fix(railcom): size identifier 3 by the channel it arrives in
    Channel 1 carries app:info1 in two symbols and channel 2 app:ext in three,
    so the flat size table lost every channel-1 window holding the identifier.
    Channel 2 also shortens app:ext to two symbols when the third carries no
    data, which recovers the window an ESU LokPilot 3 closes that way, along
    with any CV answer standing in front of it.
2026-10-12 fix(railcom): decode 0xE1 as the busy reply NMRA S-9.3.2 defines
    The code sat in the reverse table as reserved, so a decoder saying it
    could not answer read as corruption and cost the whole window, including
    any CV answer in front of it. It is now a control symbol alongside ACK
    and NACK. A busy reply carries no verdict, so a programming request is
    left unresolved for the retry rather than closed on an ACK standing
    beside a BUSY; a CV value in the same window still stands.
2026-10-12 fix(railcom): read the address flag bits instead of guessing by magnitude
    The high fragment was masked to six bits, so a decoder stating a long
    address below 128 was recorded as the short address of the same number,
    which is a different decoder on the track. One rule now reads the pair,
    in HighFragment: both flag bits mean long, neither leaves magnitude to
    decide as before, one alone is a fragment of no known form. The same
    rule decides whether a fragment answers for a programming request's
    target, where comparing the byte whole had meant a long-addressed
    decoder never matched its own target. A long address below 128 is
    outside what DccAddress holds, so it is counted apart from corrupt
    windo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
2026-10-12 fix(railcom): expire locomotive sightings instead of keeping them forever
    The Z21 RailCom lookup answered with a sighting however old it was, so a
    locomotive lifted off the track kept being reported for as long as the
    firmware ran: a sighting only left the four-slot list when four other
    addresses needed the room, and a second address practically never turns
    up. A sighting is now answered for only while it is younger than a
    freshness window, and a new address takes the slot of whichever
    locomotive has gone longest without being confirmed rather than the next
    in turn. The window is estimated, not measured: how often an
    identification arrives with the track idle is still unknown, and that is
    th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
2026-10-13 refactor(net): build the z21 handler context once per frame
2026-10-13 refactor(z21): share address, speed and central-state encoding between encoder and parser
2026-10-14 refactor(dcc): share the slot lookup and flatten the pom request
2026-10-14 fix(track): keep the dcc interrupt handlers out of the flash
2026-10-14 ci: check that the interrupt handlers reach only internal ram
2026-10-14 refactor(track): move the cutout metadata codec out of track output
2026-10-14 refactor: avoid panicking helpers, pass copy types by value and tighten the matching idioms
2026-10-14 test(status): drop the two wifi led tests the boot sequence test already covers
2026-10-16 feat(net): answer programming-on-main requests from a pending slot instead of blocking the control loop
2026-10-16 fix(dcc): serve dirty locomotive slots in rotation
2026-10-16 refactor(track): judge track power requests from all preconditions in one place
2026-10-17 refactor(dcc): tighten the protocol crate apis and keep each limit in one place
2026-10-19 refactor(dcc): keep the function state typed from the z21 parser to the scheduler slot
2026-10-19 refactor(track): build the track output handle only at boot
2026-10-19 perf(ota): hand over the executor for a tenth of a millisecond between hashed sectors
2026-10-19 refactor(scheduler): drop the railcom discovery suspend command nothing sends
2026-10-19 refactor(buttons): send the resume event from the classified press itself
2026-10-24 fix(short): tolerate keep-alive capacitor charge on a live track
    Widen the short qualification window from 20 to 100 ms and latch only
    after 75 ms of LOW samples, the fault-pin tolerance DCC-EX uses when no
    overcurrent is measured. A decoder with a large keep-alive capacitor
    set on a live track held FAULT low through the DRV8874 retry cycles
    long enough to latch a short; a dead short still latches after 75 ms.
2026-10-24 feat(pcb): publish the rev A board
    Add the KiCad project of the command-station board, the fabrication
    files of the rev A order (gerbers, BOM and placement for JLCPCB, 3D
    model, renders) and a README with the status of rev A, the parts bought
    separately and the 230 V safety rules. The hardware is released under
    CERN-OHL-S v2. The main README introduces the project as station and
    board together and links the board folder.
2026-10-27 fix(z21): report power, stop and short with the track-power frames
    Answer SET_TRACK_POWER_ON from the state found, send BC_TRACK_POWER_OFF
    on stop and fault instead of BC_STOPPED, add BC_TRACK_SHORT_CIRCUIT and
    the short bit in STATUS_CHANGED.
2026-10-27 fix(railcom): pair ADR1 and ADR2 by their RCN-217 forms
    Read the three forms of ADR1, pair a high fragment only with the next
    channel-1 window after a loco packet, and stop reading a lone ADR2 as a
    short address.
2026-10-27 feat(ota): refuse an image the bootloader would not start on this chip
    Check the header's chip revision range against the eFuses, and treat a
    USB or JTAG reset like a power loss during a trial.
2026-10-27 fix(short): settle the detector when the track is armed at boot
2026-10-30 fix(pom): release the refresh slot a read created
    A POM read left its target in the refresh cycle for good, counted as
    an active loco. The slot is now dropped when the read ends, unless a
    loco command claimed it meanwhile.
2026-11-02 feat(pcb): rev B board powered from a DC adapter
2026-11-07 fix(railcom): pair logon answers behind the break tail
    The channel-1 half of a logon answer was kept only from a two-byte
    window, but the capture window still holds the UART break-frame tail,
    so the answer never reached the 48-bit parser. The pairing now strips
    that tail first.
    A window that completes a logon answer is no longer read for address
    datagrams, so the tail of a decoder identity can no longer be taken
    for a locomotive address.
    Refs #51
2026-11-07 fix(railcom): pair logon answers only after logon packets
    Logon packets go to the broadcast address and open a telemetry
    cutout, so a window after a locomotive packet or a POM can no longer
    be taken for half of a logon answer. Every channel-1 window now
    replaces the held half instead of leaving a stale one behind.
    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
2026-11-07 fix(railcom): reject ring slots reused by a later lap
    The capture ring and the cutout event ring checked only that a slot
    was not being written. A reader lapped by the interrupt after loading
    the write count took a later window or event for the one it expected,
    lost the old one without counting it and delivered the new one twice.
    Each slot now stores its write position, and the reader counts a slot
    that holds another position as lost.
    Closes #51
2026-11-08 perf(dcc): keep one frame ahead of the rmt engine
    With sixteen frames queued a new command waited behind all of them; one
    is enough, and the interrupt fills any gap with an idle packet.
2026-11-08 feat(diag): measure frame queue waits and idle fallbacks
    Bench counters for how long a frame waits before the engine and how often
    the interrupt had to send idle for a missing frame.
2026-11-08 fix(railcom): read logon short-info addresses per RCN-218 annex D
    The short info carries the address in the 14-bit annex D form: prefix
    0x38 marks a short address in A6..A0, prefixes 0x00..0x27 a long one.
    It was read as a plain number, so every short address was rejected and
    a long address below 128 was taken as short.
    decode_address in dcc-protocol reads the prefix and rejects accessory,
    reserved and firmware-update prefixes, short address 0 and long
    addresses below 128.
2026-11-08 fix(railcom): require the short-info marker in logon answers
    RCN-218 §5.1 starts the short info with bits 10. Only bit 7 was checked,
    so a frame starting with 11, such as the ID13 answer to a logon assign,
    could be read as a short info when its CRC matched. The marker is now
    checked after the CRC.
    InvalidLogonAddress carries the raw address bytes, so the annex D layout
    lives only in decode_address.
2026-11-09 feat(railcom): put the logon behind a dcc-a feature, off by default
    Without the feature the station sends no Logon Enable and no Select.
    A DCC-A decoder that hears a Logon Enable obeys only broadcasts until it
    is assigned an address, and the station does not assign one yet.
    Closes #60
2026-11-10 feat(railcom): read logon answers by the command that asked for them
    Each cutout now carries the logon command that preceded it, so an
    answer is accepted only when it matches: the unique id after an
    enable, the short info after a select, the decoder state after an
    assign. Rejected answers come back with the reason instead of
    vanishing, and a select left unanswered is sent again.
    Closes #62
2026-11-10 feat(dcc): send the logon enable periodically
    It now goes out four times a second with its own turn, ahead of
    speed and function commands. Collisions switch it to the backoff
    group, and each track power cut starts a new session.
    Closes #64
